CatalpaEel/mynpu/npu/docs/no-sram-cache.md

# 删除透明SRAM读缓存

当前XBAR不再包含SRAM缓存数据、tag、valid数组、命中判断、填充、失效或缓存返回数据寄存器；缓存容量参数也已删除。两块8KB SRAM、256B软件管理RF、流FIFO、4/4/4任务队列和VPG3指令。

## 兼容的诊断寄存器

| CSR | 当前语义 |
|---|---|
| `0x038` | 两个32位SRAM bank、总容量16384B，保持不变 |
| `0x03c` | `0x00020000`，两个bank，每bank零个缓存字 |
| `0x020 / 0x024` | 原命中计数位置，恒为零，不保留命中计数器 |
| `0x028 / 0x02c` | SRAM读请求计数，C头文件新增`NPU_SRAM_READS0/1`别名 |
| `0x030 / 0x034` | 每个SRAM bank接受的请求数，包含读写 |

保留原寄存器地址和旧C宏名以兼容诊断软件，没有保留缓存硬件或重新启用缓存的参数。VPG2 ABI不变。

## 当前验证入口

默认配置和性能使用[项目首页](../../README.md)；当前版本的功能、综合、最终PNR及检查证据统一见[报告索引](../reports/README.md)。
