CatalpaEel/mynpu/npu/fpga/ego1/MERGE-20261114.md

# EGo1板级分支与JTAG-only主线集成

2026-11-14。本地分支`integration/ego1-board-20261114-jtag-only`合并：

- 主线父提交：`a5ac998`，已删除GPIO及外部Host，保留SBA错误和子字访问。
- 板级父提交：`efc89fd`，远端`fpga/ego1-board-20261114-afb74fd`。

本次未推送远端，也未连接、烧写实体板。

## 合入内容

板级时钟可选10/25/50MHz、FPGA专用CPU LUTRAM映射、CNN DSP约束、面积策略、构建/装载/验证/打包脚本，以及旧10MHz实板的固定归档。构建入口默认25MHz，本次FPGA仿真和Vivado展开选择10MHz；ASIC验证保持50MHz。

自动合并没有文本冲突，但`tb_validation.sv`的ASIC实例仍带旧Host端口，已移除。当前生产`npu/rtl`及`external/`与`a5ac998`完全一致，因此没有恢复GPIO/Host、修改计算阵列或改动ASIC CPU寄存器堆。LUTRAM只在明确选择FPGA映射时替换编译清单。

`versions/ego1-10mhz-20261114`保留原始字节和哈希。其中旧源码的Host端口是历史证据，不参与当前默认编译；不能修改冻结文件后继续沿用旧bitstream/板测结论。

## 本次实际检查

| 检查 | 本次结果 |
| --- | --- |
| 旧板测归档完整性 | 257文件哈希通过，72个冻结编译源 |
| PC验证脚本测试 | 13项通过，包含数据损坏、超时、序号、RPC分片、错误传播和拒绝未完成构建打包 |
| FPGA CPU LUTRAM与原FF实现对照 | 20000随机周期，40000检查通过 |
| 当前FPGA：10MHz、LUTRAM CPU RF | 两次启动、20帧、8486检查通过 |
| 当前ASIC：50MHz、真实SRAM宏 | 两次启动、20帧、8486检查通过 |
| 当前Vivado 2025.2 RTL展开 | 通过，27844个展开实例，0错误、0严重警告 |

SoC仿真均经真实JTAG TAP/DTM/DM装载、读回16KiB镜像，检查双输入槽、READY/DONE序号、十个整数输出及复位/暂停恢复；不是Host后门驱动。它们包含显式halt/resume场景，不代替专门的不暂停CPU SBA压力测试，也不证明板上SBA故障已修复。

Vivado执行的是`synth_design -rtl`，没有执行完整工艺映射、布局布线或生成新镜像。261个普通警告保留：包参数按localparam处理100、未连接/无负载端口100、CPU寄存器set/reset优先级40、MMCM未用端口等。没有屏蔽警告或将其描述为全流程Clean。

[机器结果及源/证据哈希](../../reports/ego1_merge_validation_20261114.json)。本机输出在`npu/build/ego1-merge-{fpga,asic,cpu-rf,vivado}/`；旧板测报告和本次集成验证在报告索引中分别标记。

## 历史结论的边界

旧`afb74fd/03e2870`在Vivado 2023.2下的19799 LUT、10MHz setup +48.244ns/hold +0.019ns，以及2021次实板推理只适用于冻结归档。它使用主机访问前halt/之后resume的方案。当前JTAG-only代码更新了DM，不能直接下载旧镜像来验证这些新修改。

当前机器已安装Vivado 2025.2，使用`~/tools/bin/vivado`可避开本机运行库兼容问题。要制作当前版新镜像，可从仓库根目录使用新目录：

```bash
python3.12 npu/fpga/ego1/build.py --out npu/build/ego1-merged-new \
  --clock-mhz 10 --area-medium --cpu-rf-lutram --cnn-dsp \
  --vivado /home/s2400012841/tools/bin/vivado
```

这会启动完整构建，并要求默认资源DRC、setup/hold等通过后才输出bit/MCS。该命令不自动连接或烧写板卡。
