CatalpaEel/mynpu/npu/docs/images/logic-trim-fullchip.png

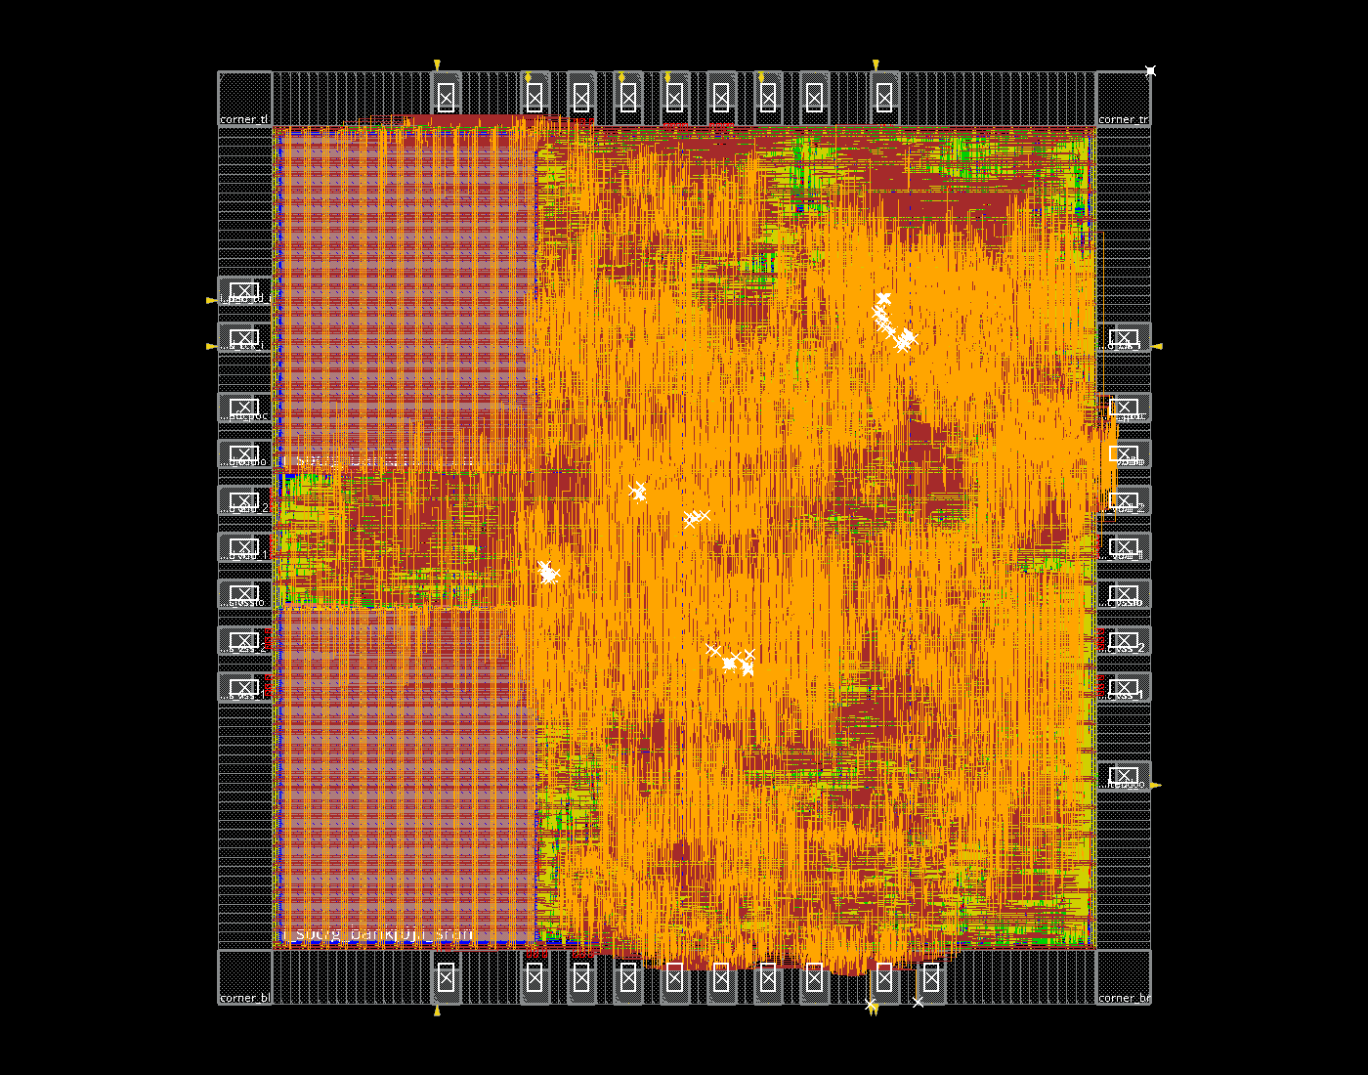
npu/docs/images/logic-trim-fullchip.png
