CatalpaEel/mynpu/npu/docs/images/regfile-pnr.png

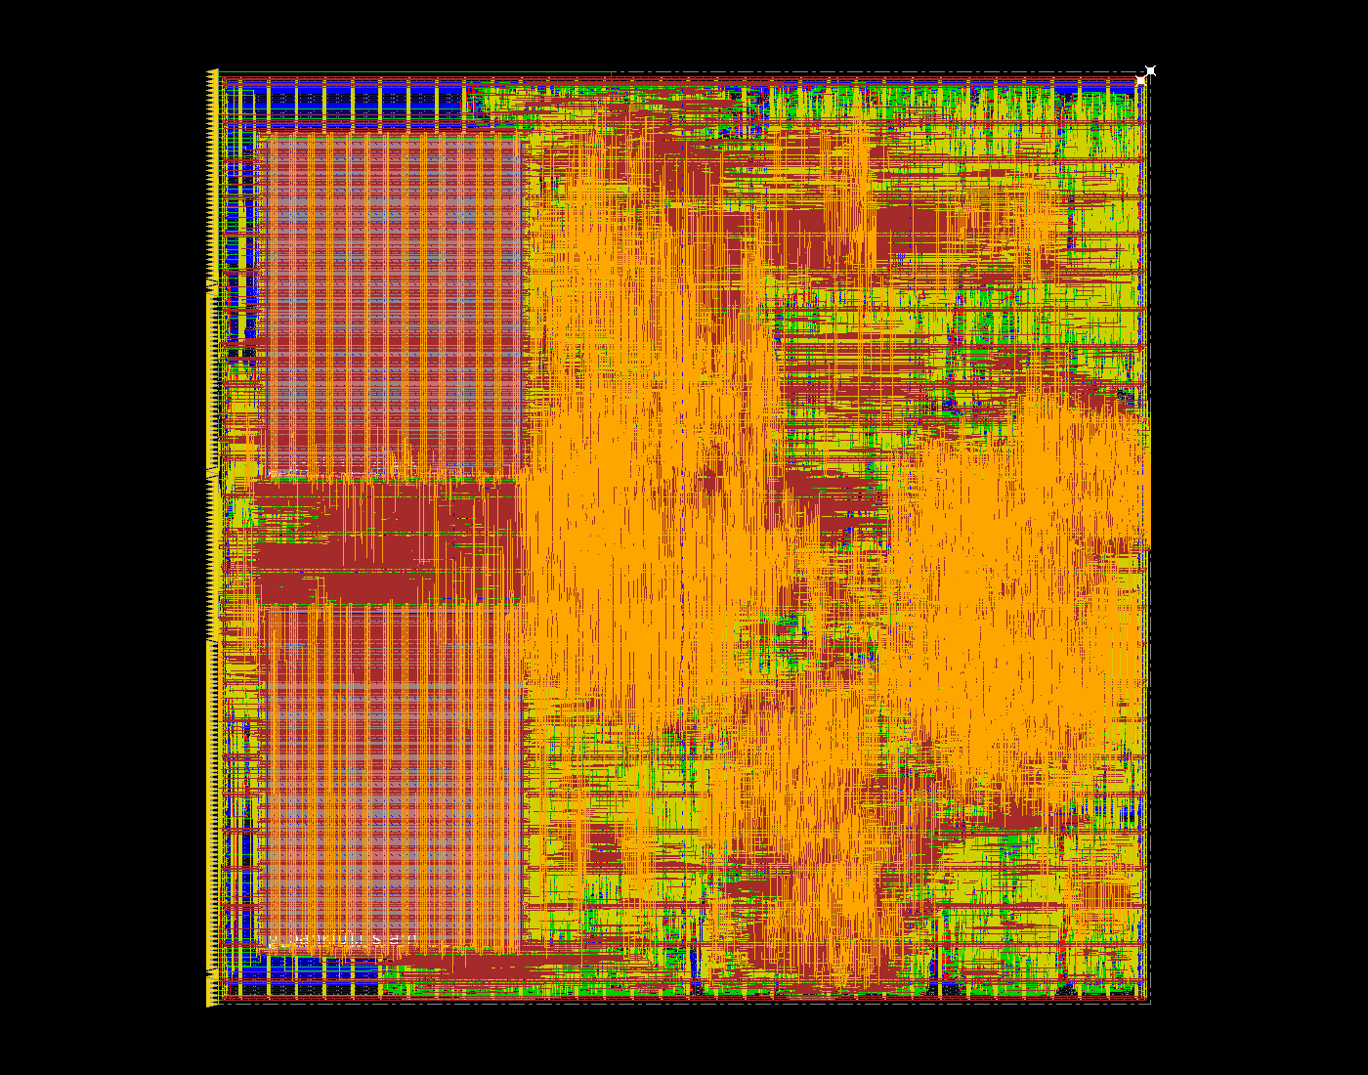
npu/docs/images/regfile-pnr.png
