CatalpaEel/mynpu/npu/docs/images/rf1r1w-r3-module-map-core.png

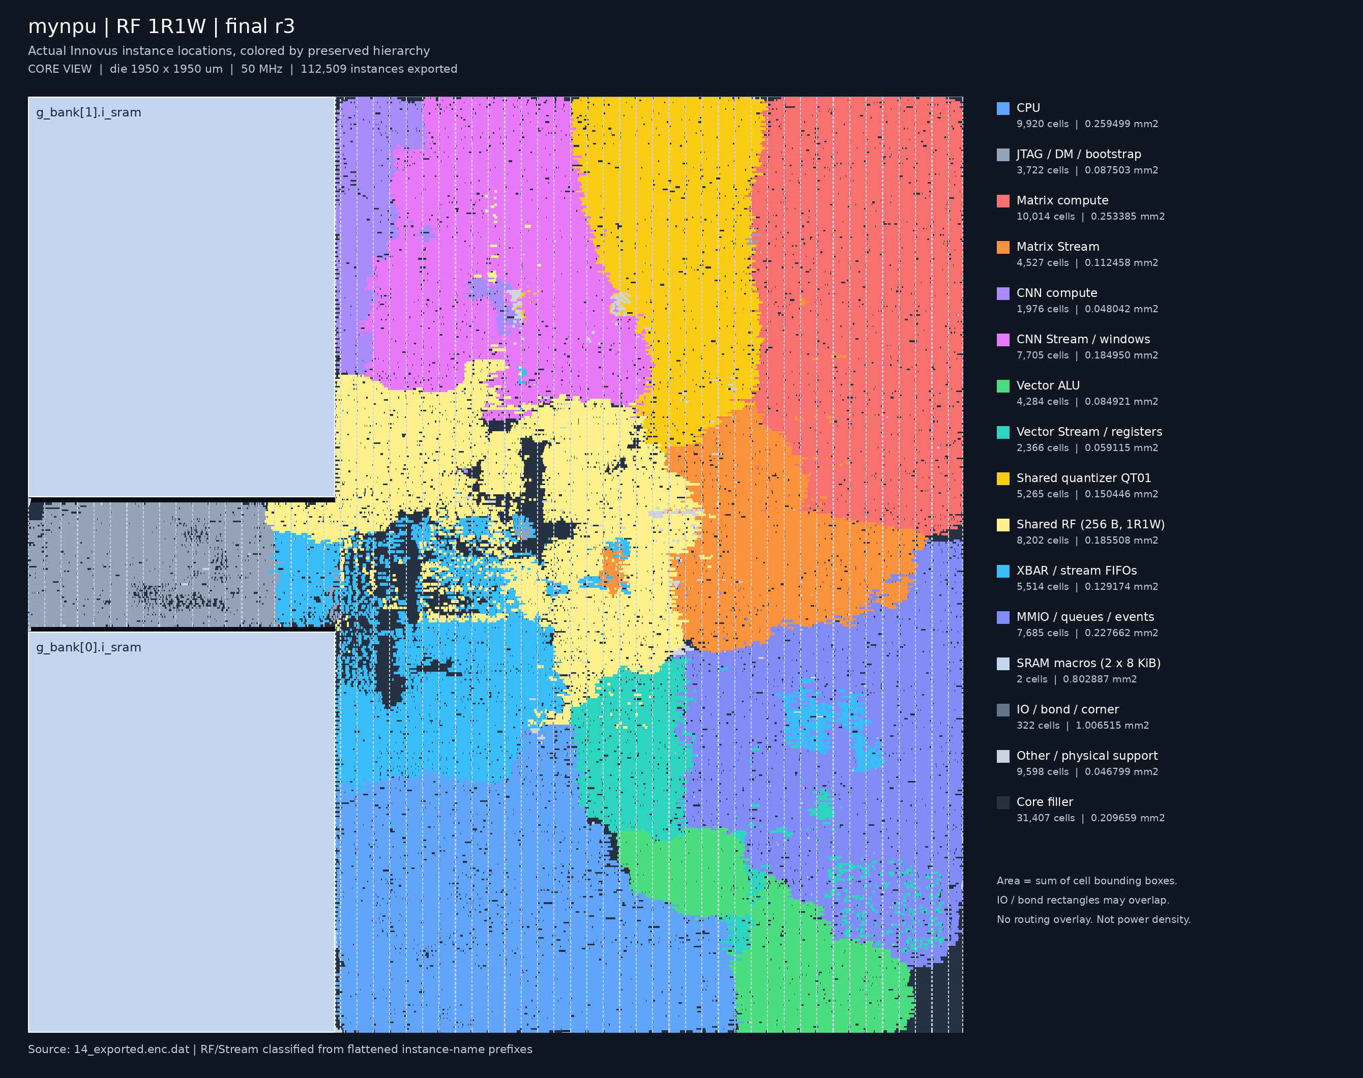
npu/docs/images/rf1r1w-r3-module-map-core.png
