CatalpaEel/mynpu/npu/docs/images/window-prefetch-module-gui.png

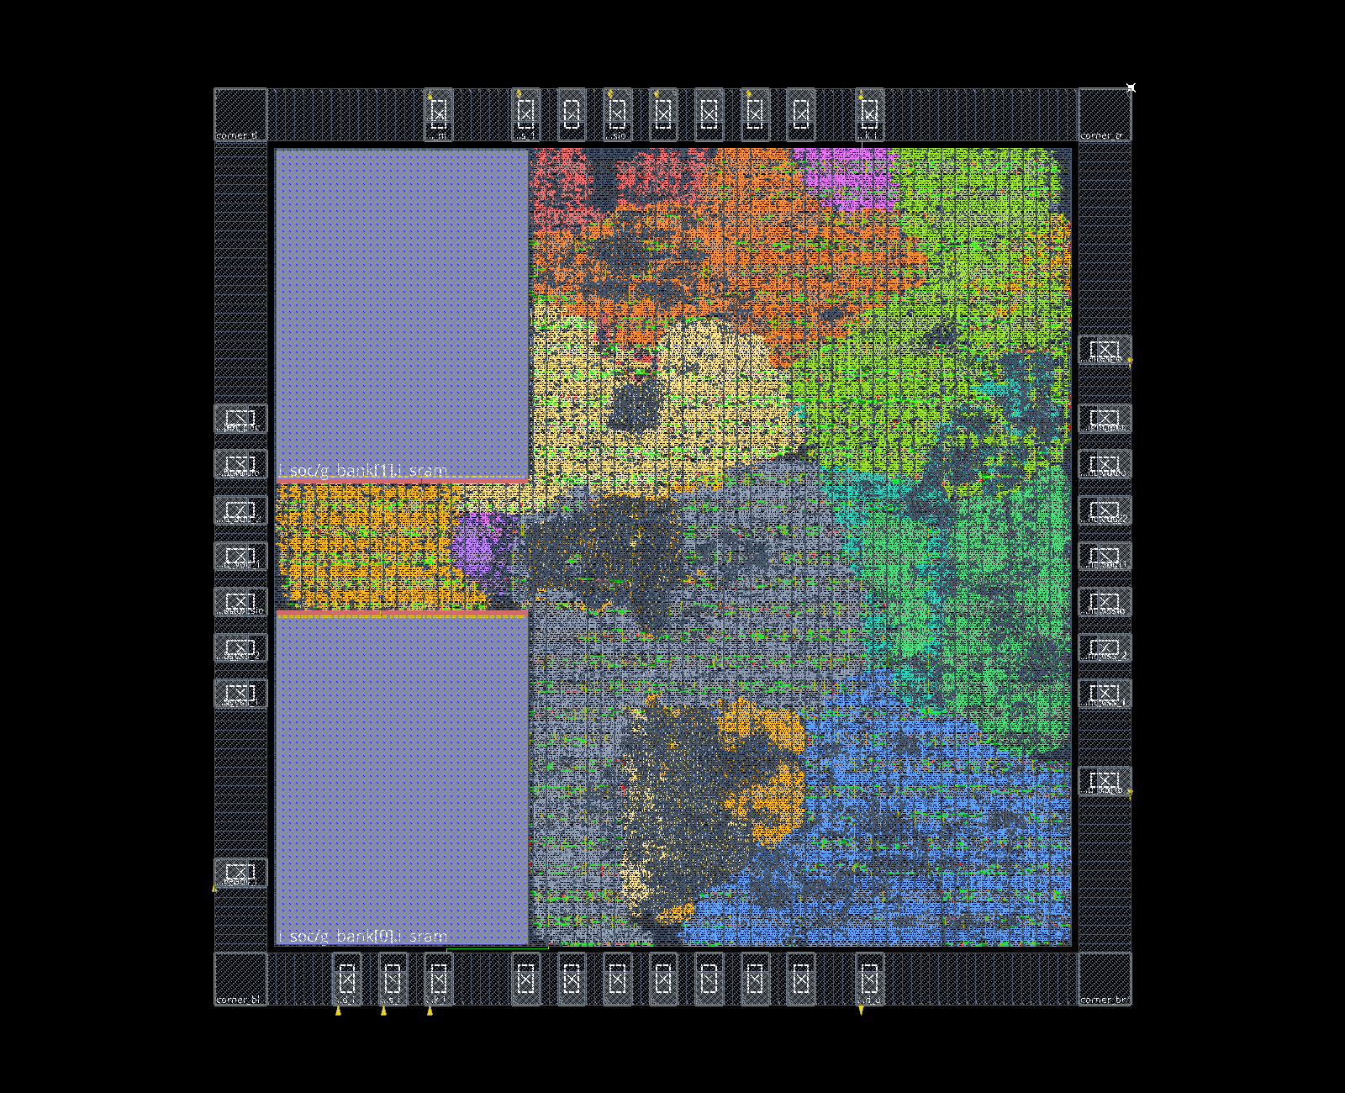
npu/docs/images/window-prefetch-module-gui.png
