CatalpaEel/mynpu/npu/docs/presentation/overview.png

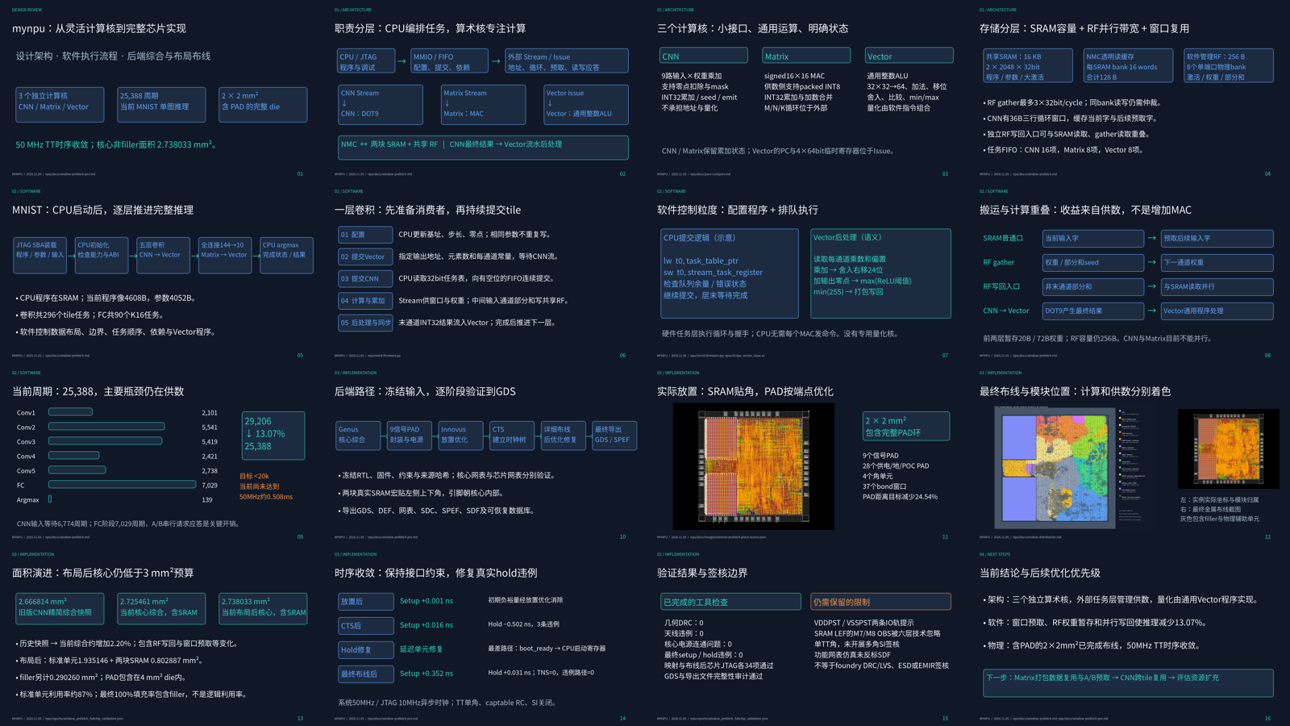
npu/docs/presentation/overview.png
