CatalpaEel/mynpu/npu/docs/presentation/slide-01.png

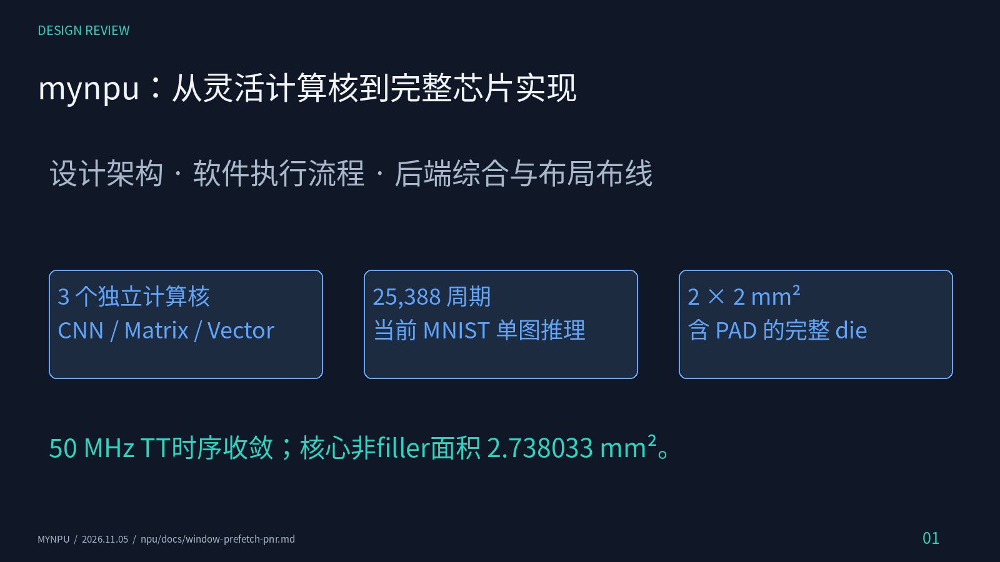
npu/docs/presentation/slide-01.png
