CatalpaEel/mynpu/npu/docs/presentation/slide-02.png

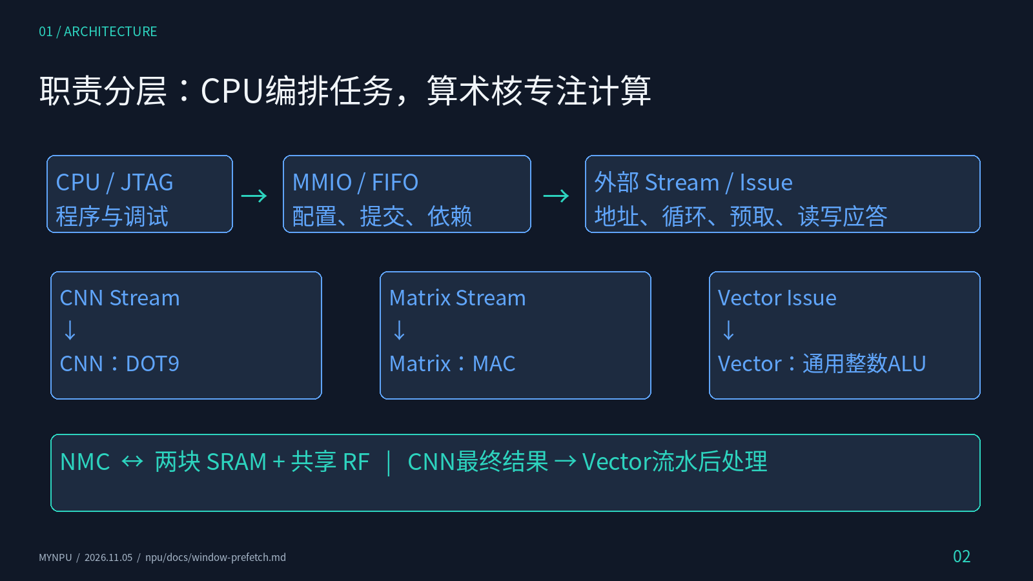
npu/docs/presentation/slide-02.png
