CatalpaEel/mynpu/npu/docs/presentation/slide-03.png

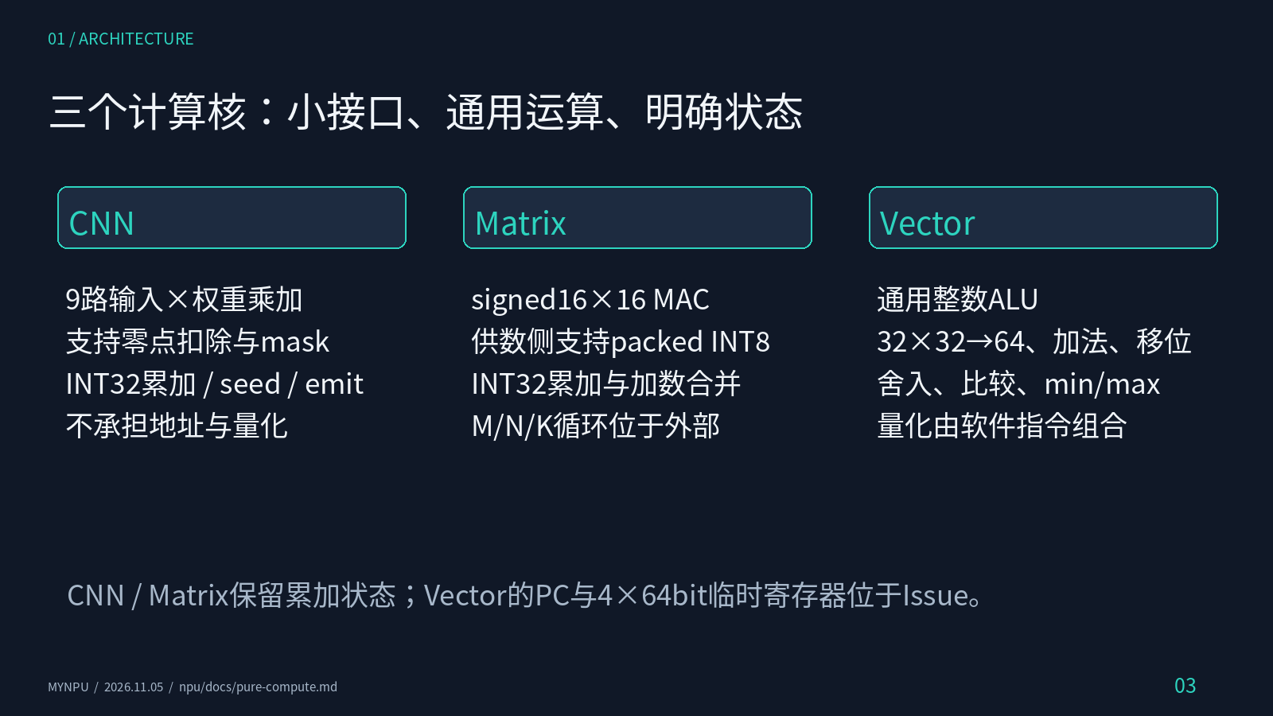
npu/docs/presentation/slide-03.png
