CatalpaEel/mynpu/npu/docs/presentation/slide-04.png

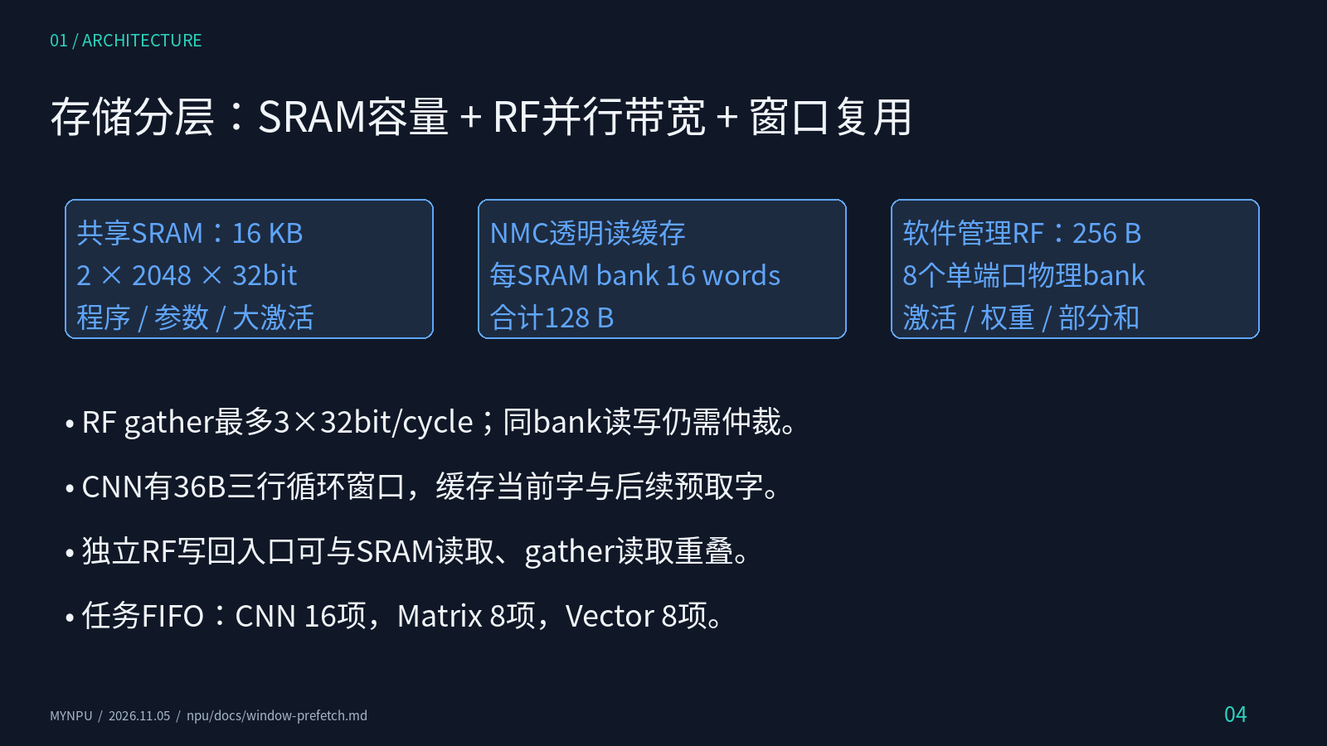
npu/docs/presentation/slide-04.png
