CatalpaEel/mynpu/npu/docs/presentation/slide-05.png

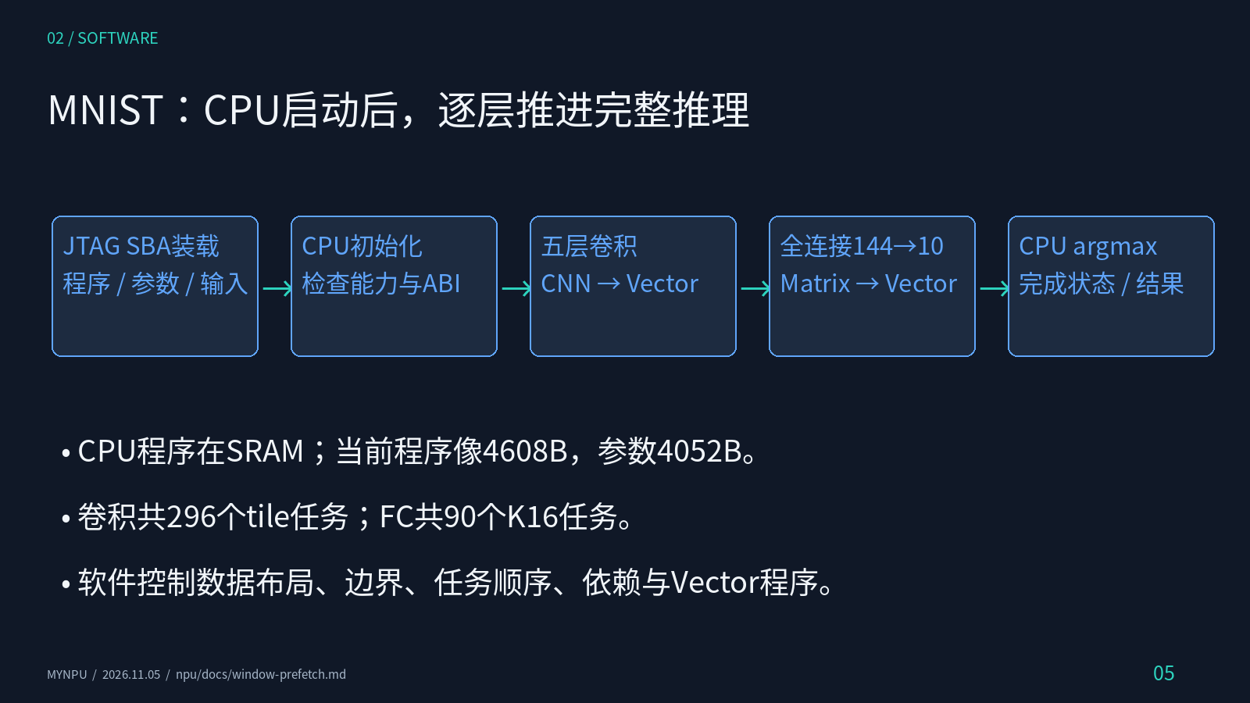
npu/docs/presentation/slide-05.png
