CatalpaEel/mynpu/npu/docs/presentation/slide-06.png

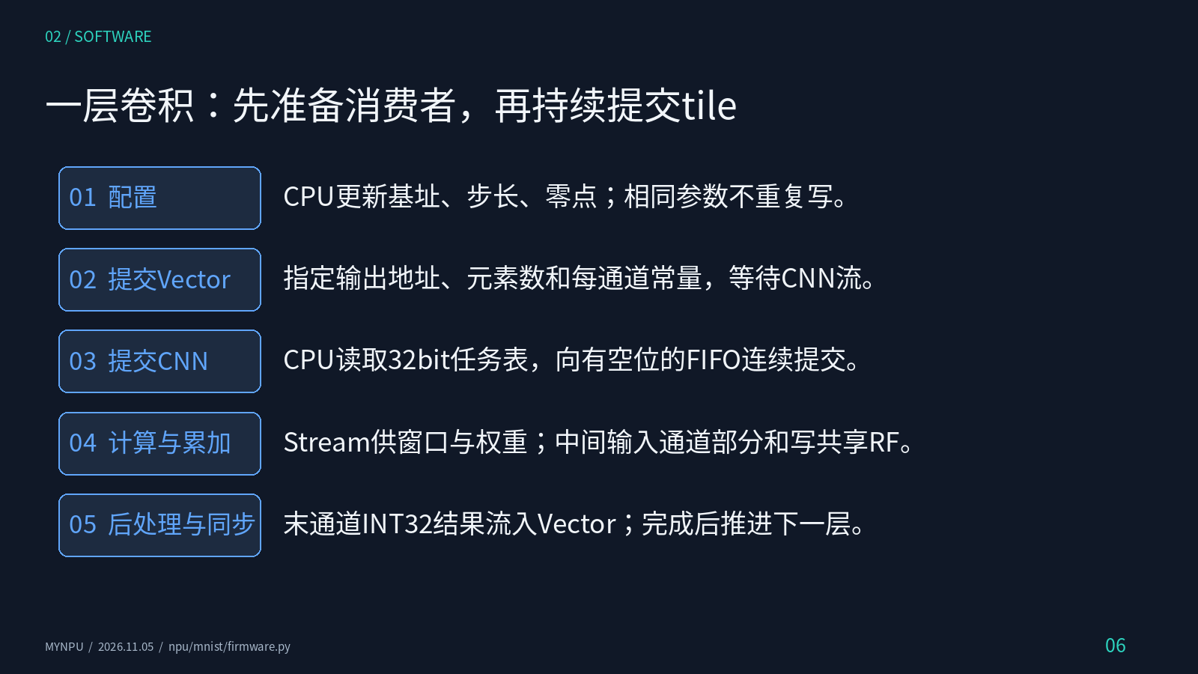
npu/docs/presentation/slide-06.png
