CatalpaEel/mynpu/npu/docs/presentation/slide-07.png

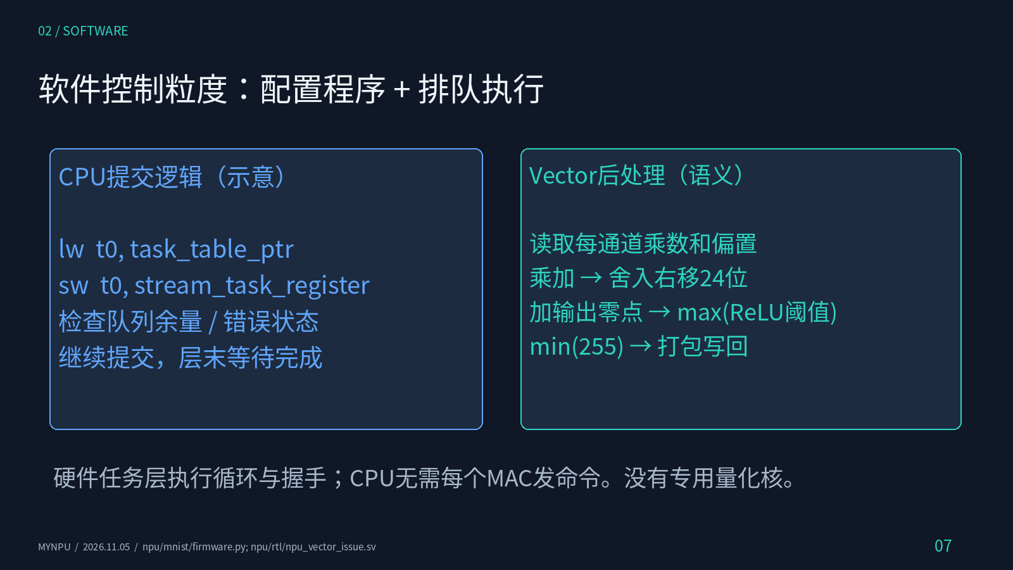
npu/docs/presentation/slide-07.png
