CatalpaEel/mynpu/npu/docs/presentation/slide-08.png

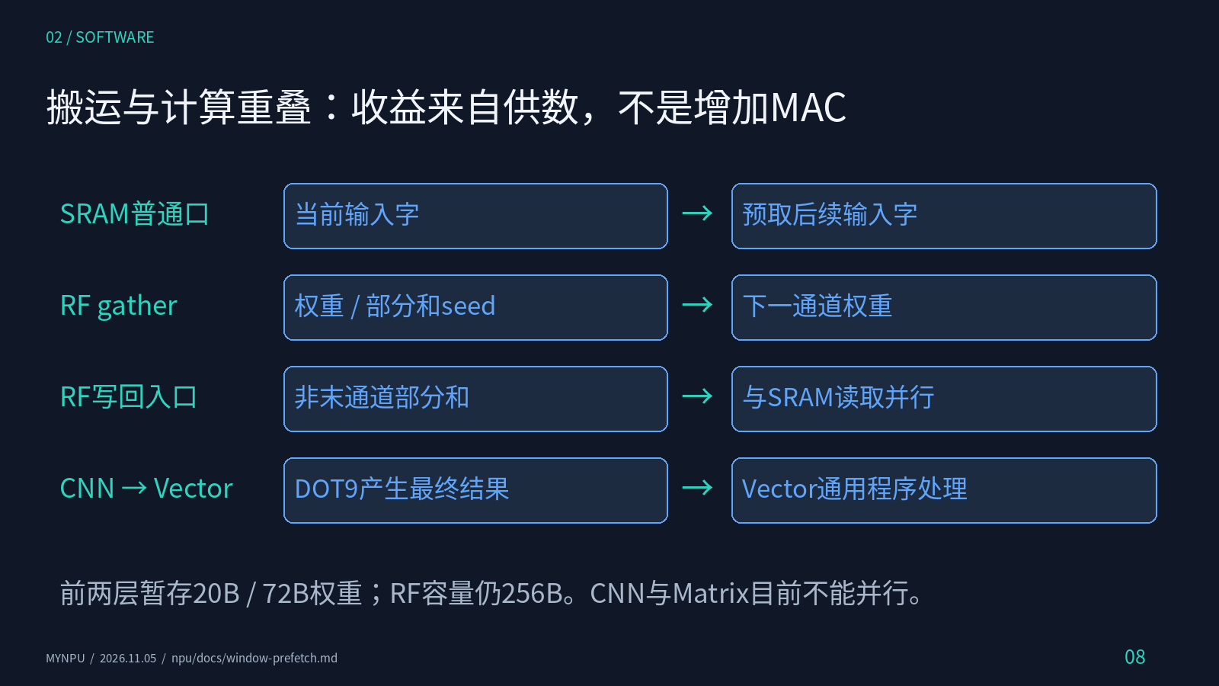
npu/docs/presentation/slide-08.png
