CatalpaEel/mynpu/npu/docs/presentation/slide-09.png

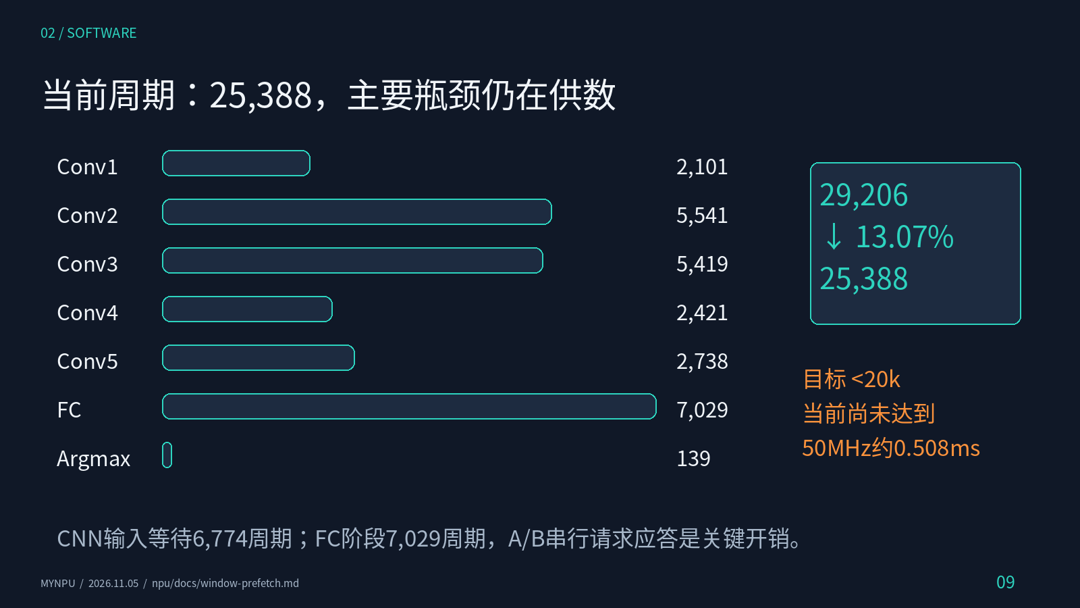
npu/docs/presentation/slide-09.png
