CatalpaEel/mynpu/npu/docs/presentation/slide-10.png

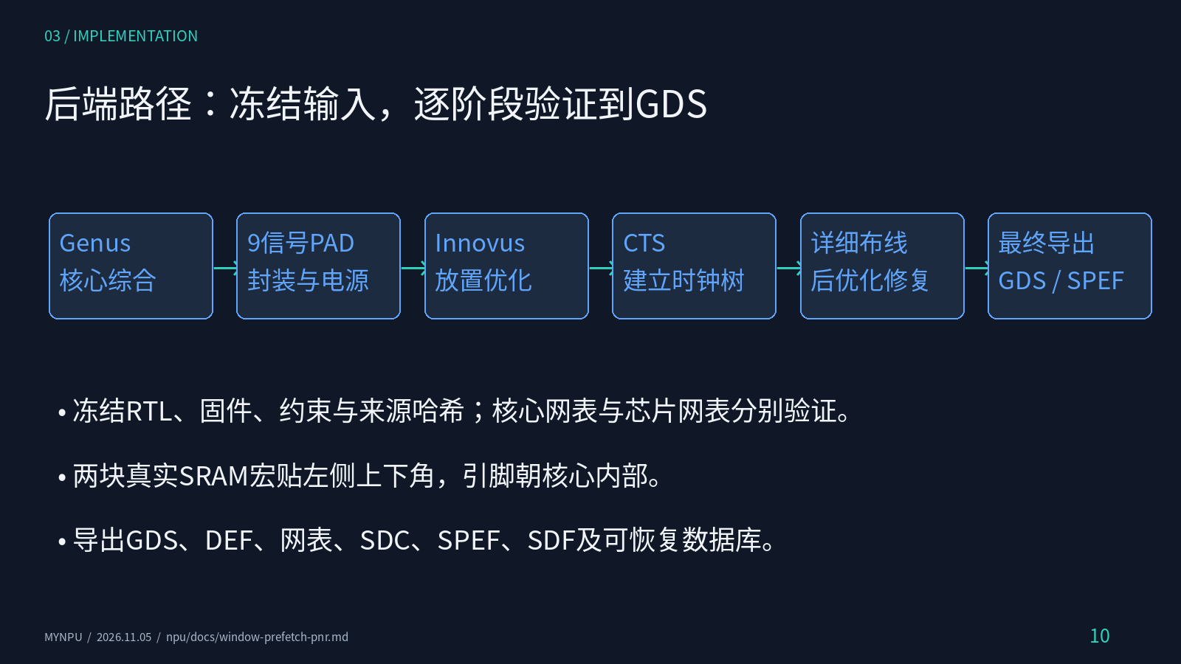
npu/docs/presentation/slide-10.png
