CatalpaEel/mynpu/npu/docs/presentation/slide-11.png

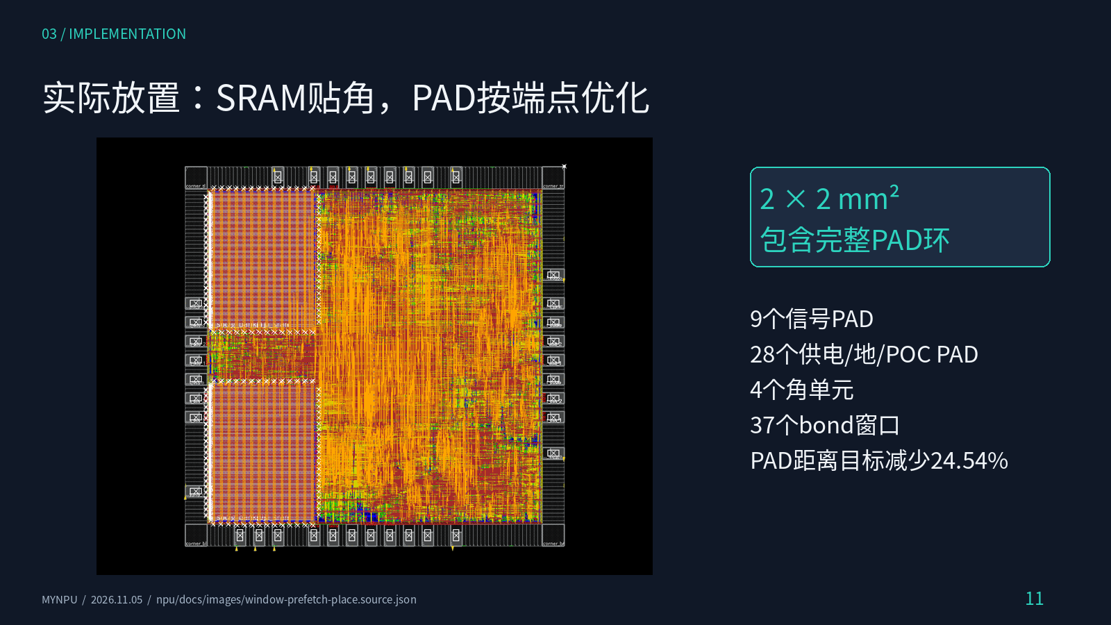
npu/docs/presentation/slide-11.png
