CatalpaEel/mynpu/npu/docs/presentation/slide-12.png

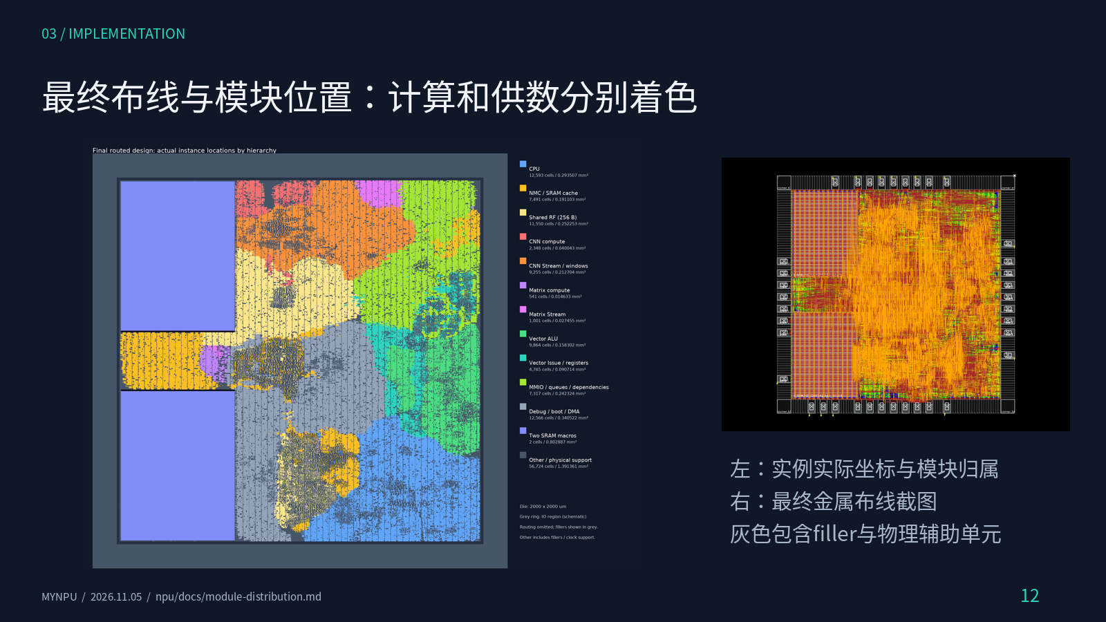
npu/docs/presentation/slide-12.png
