CatalpaEel/mynpu/npu/docs/presentation/slide-13.png

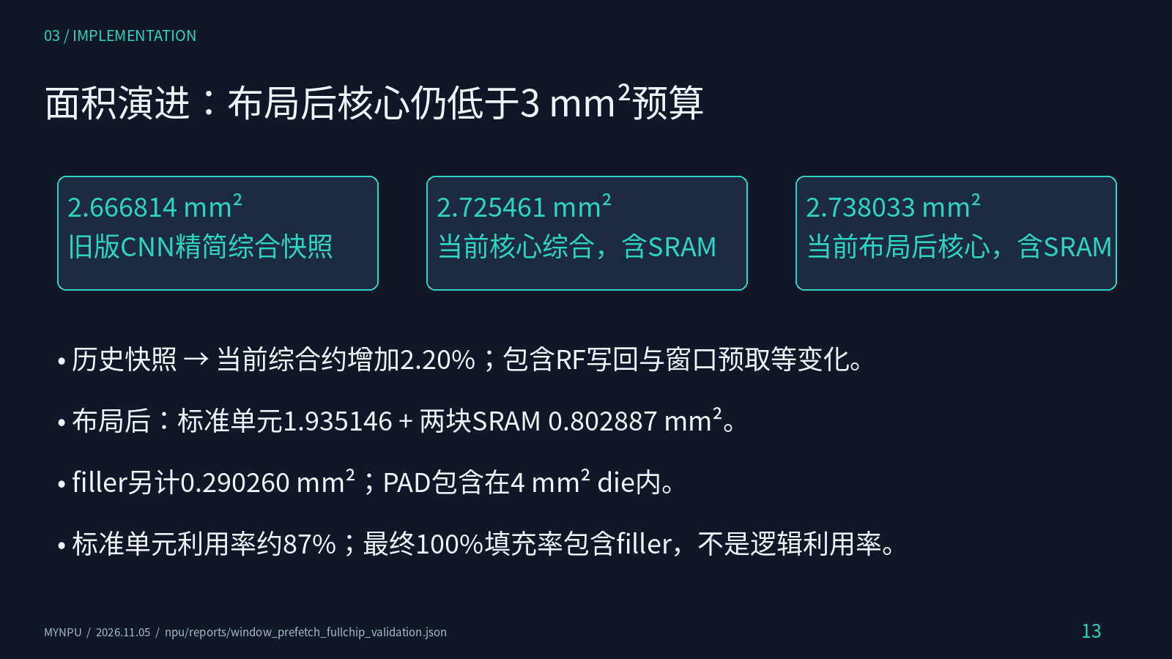
npu/docs/presentation/slide-13.png
