CatalpaEel/mynpu/npu/docs/presentation/slide-14.png

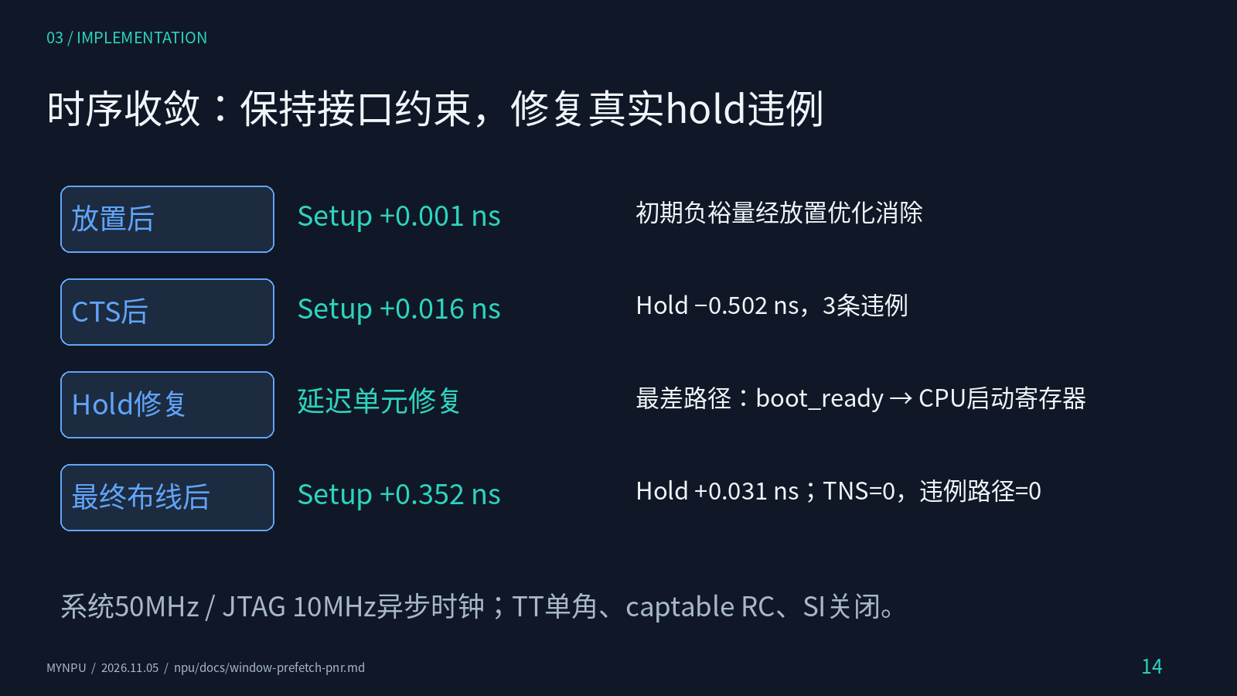
npu/docs/presentation/slide-14.png
