CatalpaEel/mynpu/npu/docs/presentation/slide-15.png

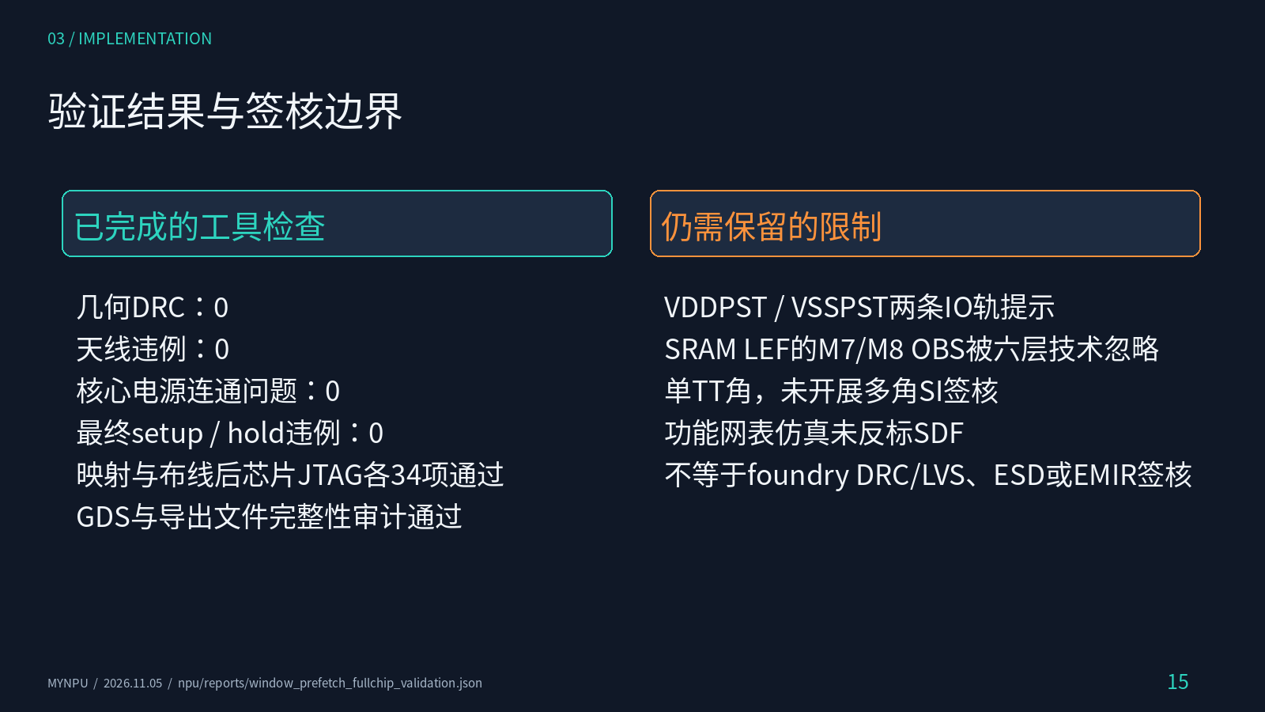
npu/docs/presentation/slide-15.png
