CatalpaEel/mynpu/npu/docs/presentation/slide-16.png

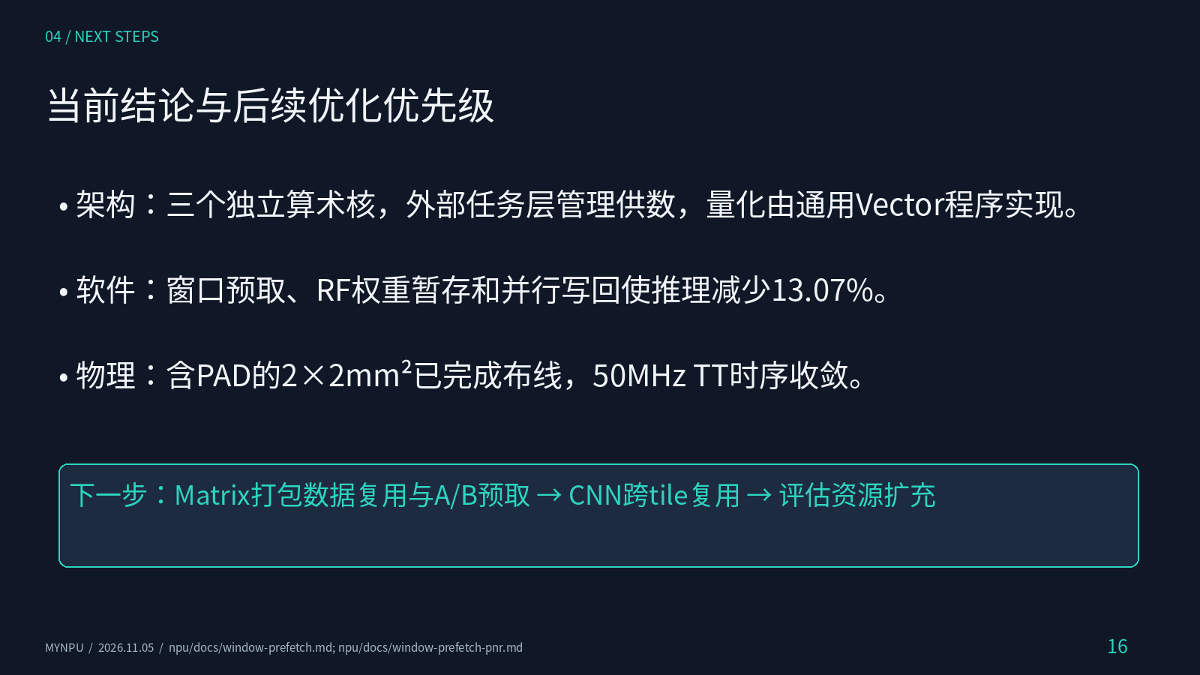
npu/docs/presentation/slide-16.png
