CatalpaEel/mynpu/npu/sw/npu.h

#ifndef NPU_H
#define NPU_H
#include <stdint.h>
/* Local machine interrupt IDs. Boot wake remains IRQ31. */
#define NPU_IRQ_MATRIX 16u
#define NPU_IRQ_VECTOR 17u
#define NPU_IRQ_CNN 18u
#define NPU_IRQ_MASK 0x00070000u
#define NPU_IRQ_CAP 0x070u
#define NPU_CONTROL_START 1u
#define NPU_CONTROL_CLEAR_IDLE 2u
#define NPU_CONTROL_ACK_DONE 8u
#define NPU_SRAM_BASE 0x80000000u
#define NPU_SRAM_BYTES 16384u
#define NPU_BANK_BYTES 8192u
#define NPU_BANK0_BASE NPU_SRAM_BASE
#define NPU_BANK1_BASE (NPU_SRAM_BASE + NPU_BANK_BYTES)
/* Uncached SRAM: legacy hits read zero; former misses count SRAM read requests. */
#define NPU_SRAM_READS0 0x028u
#define NPU_SRAM_READS1 0x02cu
#define NPU_CACHE_HITS0 0x020u
#define NPU_CACHE_HITS1 0x024u
#define NPU_CACHE_MISSES0 0x028u
#define NPU_CACHE_MISSES1 0x02cu
#define NPU_STREAM_CHANNEL_CAP 0x060u
#define NPU_STREAM_CHANNEL_BASE 0x064u
#define NPU_STREAM_ENDPOINT(channel) (0x80006000u + ((uint32_t)(channel) << 8))
#define NPU_MEMORY_CAP 0x038u
#define NPU_CACHE_CAP 0x03cu
#define NPU_REGFILE_CAP 0x050u
#define NPU_REGFILE_BASE_REG 0x054u
#define NPU_REGFILE_BASE 0x80004000u
static inline uint32_t npu_regfile_bank_bytes(void);
/* Additive LY01 layout / EV01 sticky task events. All masks are 8 bits.
 * Events are not consumed by WAIT: software clears them before safe reuse.
 * Successful completion signals after write acknowledgement; faults do not.
 */
#define NPU_LAYOUT_CAP 0x094u
#define NPU_LAYOUT_ABI 0x4c593031u
#define NPU_EVENT_CAP 0x088u
#define NPU_EVENT_ABI 0x45563031u
#define NPU_EVENT_SET 0x08cu
#define NPU_EVENT_CLEAR 0x090u
#define NPU_MAT_LDC 0x158u
#define NPU_MAT_EVENTS 0x15cu
#define NPU_VEC_A_STRIDE 0x28cu
#define NPU_VEC_B_STRIDE 0x290u
#define NPU_VEC_D_STRIDE 0x294u
#define NPU_VEC_LAYOUT 0x298u
#define NPU_VEC_EVENTS 0x29cu
#define NPU_CNN_EVENTS 0x674u
#define NPU_VEC_FINAL_ONLY 1u
#define NPU_VEC_KEEP_R2 2u
#define NPU_VEC_STRIDES 4u
struct npu_vector_layout {
  int32_t a_stride, b_stride, d_stride;
  uint32_t flags, events;
};
static inline uint32_t npu_task_events(unsigned wait_mask, unsigned signal_mask) {
  return (wait_mask & 255u) | ((signal_mask & 255u) << 8);
}
static inline int npu_vector_layout_valid(const struct npu_vector_layout *l, int packed) {
  return l && l->flags <= 7u && l->events <= 65535u && l->a_stride >= -32768 &&
         l->a_stride <= 32767 && l->b_stride >= -32768 && l->b_stride <= 32767 &&
         l->d_stride >= -32768 && l->d_stride <= 32767 &&
         (!(l->flags & NPU_VEC_STRIDES) ||
          (!(l->a_stride & 3) && !(l->b_stride & 3) && (packed || !(l->d_stride & 3))));
}
#define NPU_MAT_CONTROL 0x100u
#define NPU_MAT_STATUS 0x104u
#define NPU_VEC_CONTROL 0x200u
#define NPU_VEC_STATUS 0x204u
#define NPU_MAT_QUEUE 0x124u
#define NPU_MAT_COMPLETED 0x128u
#define NPU_MAT_SUBMITTED 0x12cu
#define NPU_VEC_QUEUE 0x224u
#define NPU_VEC_COMPLETED 0x228u
#define NPU_VEC_SUBMITTED 0x22cu
/* Operator ABI 2.2, project-defined integer kernels (not an ISA extension). */
#define NPU_OPERATOR_ABI 0x040u
/* Read-only observation ABI 2; bits0..6 include packed-write cancellations. */
#define NPU_SYNC_CAP 0x084u
#define NPU_SYNC_ABI_V1 0x0001003fu
#define NPU_SYNC_ABI_V2 0x0002007fu
#define NPU_MAT_STARTED 0x144u
#define NPU_MAT_STARTED_TICKET 0x148u
#define NPU_MAT_FAULTS 0x14cu
#define NPU_MAT_OBSERVE 0x150u
#define NPU_MAT_SYNC_STATE 0x154u
#define NPU_VEC_STARTED 0x238u
#define NPU_VEC_STARTED_TICKET 0x23cu
#define NPU_VEC_FAULTS 0x280u
#define NPU_VEC_OBSERVE 0x284u
#define NPU_VEC_SYNC_STATE 0x288u
#define NPU_CNN_STARTED 0x634u
#define NPU_CNN_STARTED_TICKET 0x638u
#define NPU_CNN_FAULTS 0x63cu
#define NPU_CNN_CANCELLED 0x648u
#define NPU_CNN_OBSERVE 0x64cu
#define NPU_CNN_SYNC_STATE 0x650u
#define NPU_SYNC_BUSY (1u << 0)
#define NPU_SYNC_LAUNCH (1u << 1)
#define NPU_SYNC_QUEUED (1u << 2)
#define NPU_SYNC_DONE_PULSE (1u << 3)
#define NPU_SYNC_FAULT_PULSE (1u << 4)
#define NPU_SYNC_BLOCKED (1u << 5)
/* Relative to NPU_QUANT_SYNC_BASE(source). Counts wrap, reset only on reset. */
#define NPU_QUANT_SYNC_BASE(source) (0x700u + ((uint32_t)(source) << 6))
#define NPU_QUANT_ACCEPTED 0x24u
#define NPU_QUANT_ISSUED 0x28u
#define NPU_QUANT_WRITTEN 0x2cu
#define NPU_QUANT_WRITE_ERRORS 0x30u
#define NPU_QUANT_FLUSHED 0x34u
#define NPU_QUANT_SYNC_STATE 0x38u
#define NPU_QUANT_WRITE_CANCELLED 0x3cu
/* Valid for less than 2^31 events between baseline and observation. Following
 * a fault/cancellation, started/completed event counts are not submit tickets. */
static inline int npu_counter_reached(uint32_t observed, uint32_t target) {
  return observed - target < 0x80000000u;
}
#define NPU_RUNTIME_CONFIG_CAP 0x080u /* bits0..3: CNN, Matrix, Vector, quant */
#define NPU_GEMM_CAP 0x044u
#define NPU_VECTOR_CAP 0x048u
#define NPU_CNN_CAP 0x04cu
#define NPU_MAT_FLAGS 0x130u
#define NPU_VEC_SCALAR 0x230u
#define NPU_GEMM_TRANS_A 1u
#define NPU_GEMM_TRANS_B 2u
#define NPU_GEMM_ACCUMULATE 4u
#define NPU_MATRIX_PRECISION 0x13cu
#define NPU_MATRIX_ELEMENT_BYTES 0x140u
#define NPU_PRECISION_INT8 0u
#define NPU_PRECISION_INT16 1u
#define NPU_VECTOR_SCALAR 128u
enum npu_vector_op {
  NPU_V_RELU = 0,
  NPU_V_ADD = 1,
  NPU_V_COPY = 2,
  NPU_V_SUB = 3,
  NPU_V_MIN = 4,
  NPU_V_MAX = 5,
  NPU_V_AND = 6,
  NPU_V_OR = 7,
  NPU_V_XOR = 8,
  NPU_V_SHL = 9,
  NPU_V_SHR = 10,
  NPU_V_SAR = 11,
  NPU_V_EQ = 12,
  NPU_V_NEG = 13,
  NPU_V_ABS = 14,
  NPU_V_NOT = 15,
  NPU_V_MUL32 = 24,
  NPU_V_RSHR32 = 26,
  NPU_V_LD32 = 27,
  NPU_V_ADDC = 16,
  NPU_V_ADC = 17,
  NPU_V_SLTU = 18,
  NPU_V_MULHU = 19,
  NPU_V_MULH = 20,
  NPU_V_SHRD = 21,
  NPU_V_RSHRD = 22,
  NPU_V_ADCSX = 23,
  NPU_V_SCALAR = 29
};
enum npu_cnn_op { NPU_CONV = 0 };
#define NPU_V_PROGRAM 32u
#define NPU_V_SIMD8 64u
#define NPU_V_SCALAR_INPUT 128u
#define NPU_VECTOR_SIMD_CAP 0x068u
#define NPU_V_PACK_U8 256u
#define NPU_VECTOR_PROGRAM_ABI 0x058u
#define NPU_VECTOR_PROGRAM_ABI_V3 0x56504733u
#define NPU_VEC_PROGRAM_CFG 0x234u
#define NPU_VEC_PROGRAM_WORDS 0x240u
struct npu_gemm_descriptor {
  uint32_t a, b, d, m, n, k, flags, precision, element_bytes, lda, ldb;
};
struct npu_vector_descriptor {
  uint32_t a, b, d, len, op, scalar;
};
#define NPU_MMIO_BASE 0x40000000u
#define NPU_BUSY 1u
#define NPU_DONE 2u
#define NPU_ERROR 4u
/* Optional transport hooks also allow host-side validation of queue helpers. */
#ifndef NPU_MMIO_READ32
#define NPU_MMIO_READ32(address) (*(volatile uint32_t *)(uintptr_t)(address))
#endif
#ifndef NPU_MMIO_WRITE32
#define NPU_MMIO_WRITE32(address, value) (*(volatile uint32_t *)(uintptr_t)(address) = (value))
#endif
#ifndef NPU_IO_FENCE
#define NPU_IO_FENCE() __asm__ volatile("fence iorw, iorw" ::: "memory")
#endif
static inline void npu_write(uint32_t offset, uint32_t value) {
  NPU_MMIO_WRITE32(NPU_MMIO_BASE + offset, value);
}
static inline uint32_t npu_read(uint32_t offset) { return NPU_MMIO_READ32(NPU_MMIO_BASE + offset); }

/* GPIO8 on the XBAR MMIO slave: full aligned 32-bit accesses, low byte only.
 * DIR bit 1 drives OUT; bit 0 releases the corresponding bidirectional pin.
 * Write OUT before enabling DIR to avoid an unintended transition. No IRQ.
 */
#define NPU_GPIO_IN 0x800u
#define NPU_GPIO_OUT 0x804u
#define NPU_GPIO_DIR 0x808u
#define NPU_GPIO_SET 0x80cu
#define NPU_GPIO_CLEAR 0x810u
#define NPU_GPIO_TOGGLE 0x814u
#define NPU_GPIO_CAP 0x818u
static inline uint8_t npu_gpio_read(void) { return (uint8_t)npu_read(NPU_GPIO_IN); }
static inline void npu_gpio_write(uint8_t value) { npu_write(NPU_GPIO_OUT, value); }
static inline void npu_gpio_direction(uint8_t outputs) { npu_write(NPU_GPIO_DIR, outputs); }
static inline void npu_gpio_set(uint8_t mask) { npu_write(NPU_GPIO_SET, mask); }
static inline void npu_gpio_clear(uint8_t mask) { npu_write(NPU_GPIO_CLEAR, mask); }
static inline void npu_gpio_toggle(uint8_t mask) { npu_write(NPU_GPIO_TOGGLE, mask); }
/* Read only NPU-local pending sources; CPU mie controls wake/interrupt masks. */
static inline uint32_t npu_irq_pending(void) {
  uint32_t value;
  __asm__ volatile("csrr %0, mip" : "=r"(value));
  return value & NPU_IRQ_MASK;
}
/* Acknowledge done while active; error and completion counters are unchanged. */
static inline void npu_irq_ack_done(uint32_t control_offset) {
  npu_write(control_offset, NPU_CONTROL_ACK_DONE);
}
static inline void npu_fence(void) { NPU_IO_FENCE(); }
static inline uint32_t npu_regfile_bank_bytes(void) {
  return (npu_read(NPU_REGFILE_CAP) & 65535u) * 4u;
}
/* Returns 0 on completion, -1 on command error, -2 on timeout. */
static inline int npu_wait(uint32_t status_offset, uint32_t timeout) {
  while (timeout--) {
    uint32_t s = npu_read(status_offset);
    if (s & NPU_ERROR)
      return -1;
    if ((s & (NPU_BUSY | NPU_DONE)) == NPU_DONE) {
      npu_fence();
      return 0;
    }
  }
  return -2;
}
/* Nonblocking descriptor enqueue; software must serialize shadow-CSR producers.
 * Queue depth excludes the active job. A snapshot is captured on CONTROL.start.
 * Buffer dependencies across queued jobs/units remain a software responsibility. */
static inline int npu_queue_has_space(uint32_t offset) {
  uint32_t q = npu_read(offset);
  return (q & 0xffffu) < (q >> 16);
}
/* Completion tickets are modulo 2^32; keep fewer than 2^31 outstanding. */
static inline int npu_queue_wait(uint32_t completed, uint32_t status, uint32_t ticket,
                                 uint32_t timeout) {
  while (timeout--) {
    if (npu_read(status) & NPU_ERROR)
      return -1;
    if ((int32_t)(npu_read(completed) - ticket) >= 0) {
      npu_fence();
      return 0;
    }
  }
  return -2;
}
static inline int npu_matmul_start(uint32_t a, uint32_t b, uint32_t d, uint32_t m, uint32_t n,
                                   uint32_t k) {
  if (!npu_queue_has_space(NPU_MAT_QUEUE))
    return -1;
  uint32_t before = npu_read(NPU_MAT_SUBMITTED);
  npu_write(0x108, a);
  npu_write(0x10c, b);
  npu_write(0x110, d);
  npu_write(0x114, m);
  npu_write(0x118, n);
  npu_write(0x11c, k);
  npu_write(NPU_MATRIX_PRECISION, NPU_PRECISION_INT8);
  npu_write(NPU_MATRIX_ELEMENT_BYTES, 4);
  npu_write(0x134, 0);
  npu_write(0x138, 0);
  npu_write(NPU_MAT_FLAGS, 0);
  npu_write(NPU_MAT_LDC, 0);
  npu_write(NPU_MAT_EVENTS, 0);
  npu_fence();
  npu_write(0x100, 1);
  return npu_read(NPU_MAT_SUBMITTED) == before + 1u ? 0 : -1;
}
static inline int npu_vector_start(uint32_t a, uint32_t b, uint32_t d, uint32_t len, uint32_t op) {
  if (op > 15u)
    return -1; /* Scalar form uses npu_elementwise_start. */
  if (!npu_queue_has_space(NPU_VEC_QUEUE))
    return -1;
  uint32_t before = npu_read(NPU_VEC_SUBMITTED);
  npu_write(0x208, a);
  npu_write(0x218, b);
  npu_write(0x20c, d);
  npu_write(0x210, len);
  npu_write(0x214, op);
  npu_write(NPU_VEC_LAYOUT, 0);
  npu_write(NPU_VEC_EVENTS, 0);
  npu_fence();
  npu_write(0x200, 1);
  return npu_read(NPU_VEC_SUBMITTED) == before + 1u ? 0 : -1;
}
/* Dense row-major GEMM, D=op(A)*op(B), or D+= when ACCUMULATE.
 * All bases are 4-byte aligned; packed rows need no padding. INT32 output.
 * Precision selects signed INT8/INT16. element_bytes independently selects
 * a 1/2/4-byte storage slot; INT16 needs at least 2. Accumulation wraps INT32. */
/* Per-job limits; address capacity can impose a tighter bound. */
#define NPU_MATRIX_SHAPE_CAP 0x074u /* [31:16]=K, [15:8]=N, [7:0]=M */
#define NPU_VECTOR_LENGTH_CAP 0x078u
#define NPU_CNN_INPUT_CHANNEL_CAP 0x07cu
#define NPU_MATRIX_MAX_M 16u
#define NPU_MATRIX_MAX_N 16u
#define NPU_MATRIX_MAX_K 256u
#define NPU_VECTOR_MAX_ELEMENTS 4096u
#define NPU_CNN_MAX_INPUT_CHANNELS 256u
#define NPU_MATRIX_OUTER_CAP 0x06cu
#define NPU_MATRIX_LDA 0x134u
#define NPU_MATRIX_LDB 0x138u
/* Configure stride shadows for raw-MMIO submissions; START snapshots them.
 * npu_gemm_start uses its descriptor lda/ldb. Zero selects dense layout. */
static inline int npu_gemm_leading_dims(uint32_t lda, uint32_t ldb) {
  if (lda > 4096u || ldb > 4096u || npu_read(NPU_MATRIX_OUTER_CAP) != 0x00040404u)
    return -1;
  npu_write(NPU_MATRIX_LDA, lda);
  npu_write(NPU_MATRIX_LDB, ldb);
  return 0;
}
static inline int npu_gemm_start_layout(const struct npu_gemm_descriptor *d, uint32_t ldc,
                                        uint32_t events) {
  if (!d || ldc > 4096u || (ldc && ldc < d->n) || events > 65535u)
    return -1;
  if ((npu_read(NPU_OPERATOR_ABI) >> 16) != 2u || (d->flags & ~npu_read(NPU_GEMM_CAP)))
    return -1;
  if (d->precision > 1 ||
      (d->element_bytes != 1 && d->element_bytes != 2 && d->element_bytes != 4) ||
      (d->precision && d->element_bytes < 2) || d->lda > 4096 || d->ldb > 4096)
    return -1;
  if (!npu_queue_has_space(NPU_MAT_QUEUE))
    return -1;
  uint32_t before = npu_read(NPU_MAT_SUBMITTED);
  npu_write(0x108, d->a);
  npu_write(0x10c, d->b);
  npu_write(0x110, d->d);
  npu_write(0x114, d->m);
  npu_write(0x118, d->n);
  npu_write(0x11c, d->k);
  npu_write(NPU_MATRIX_PRECISION, d->precision);
  npu_write(NPU_MATRIX_ELEMENT_BYTES, d->element_bytes);
  npu_write(NPU_MATRIX_LDA, d->lda);
  npu_write(NPU_MATRIX_LDB, d->ldb);
  npu_write(NPU_MAT_FLAGS, d->flags);
  npu_write(NPU_MAT_LDC, ldc);
  npu_write(NPU_MAT_EVENTS, events);
  npu_fence();
  npu_write(0x100, 1);
  return npu_read(NPU_MAT_SUBMITTED) == before + 1u ? 0 : -1;
}
static inline int npu_gemm_start(const struct npu_gemm_descriptor *d) {
  return npu_gemm_start_layout(d, 0, 0);
}
/* Optional direct CNN/Matrix result quantizer. Software owns update timing.
 * Arithmetic parameters are sampled per result; enable/pack/dst are live.
 * A zero control preserves raw INT32.
 * Destination describes the final output; Matrix D still names raw partials.
 */
#define NPU_QUANT_CNN 0u
#define NPU_QUANT_MATRIX 1u
#define NPU_QUANT_CAP 0x780u
#define NPU_QUANT_ABI 0x51543031u
struct npu_quant_config {
  uint32_t control, multiplier, bias, shift, zero, lower, upper, input_offset, dst;
};
static inline int npu_quant_configure(uint32_t source, const struct npu_quant_config *q) {
  if (source > 1u || !q || npu_read(NPU_QUANT_CAP) != NPU_QUANT_ABI || q->control > 3u ||
      q->control == 2u || q->shift > 32u || (int32_t)q->lower > (int32_t)q->upper ||
      (q->control == 1u && (q->dst & 3u)) ||
      (q->control == 3u && q->dst >= 0x80006000u && q->dst < 0x80006400u))
    return -1;
  uint32_t base = 0x700u + source * 64u;
  if (q->control && !((q->dst - NPU_SRAM_BASE < NPU_SRAM_BYTES) ||
                      (q->dst - NPU_REGFILE_BASE < 2u * npu_regfile_bank_bytes()) ||
                      (q->control == 1u && q->dst >= 0x80006000u && q->dst < 0x80006400u)))
    return -1;
  npu_write(base, 0);
  if (!q->control)
    return 0;
  npu_write(base + 4, q->multiplier);
  npu_write(base + 8, q->bias);
  npu_write(base + 12, q->shift);
  npu_write(base + 16, q->zero);
  npu_write(base + 20, q->lower);
  npu_write(base + 24, q->upper);
  npu_write(base + 28, q->input_offset);
  npu_write(base + 32, q->dst);
  npu_fence();
  npu_write(base, q->control);
  return 0;
}
/* Extended traversal bounds, aliases and KEEP_R2 lifetime are software-owned.
 * SIMD strides advance once per four-byte group. Packed program D strides
 * advance per output byte. With STRIDES clear, legacy dense addressing applies.
 */
static inline int npu_elementwise_start_layout(const struct npu_vector_descriptor *d,
                                               const struct npu_vector_layout *l) {
  if (!d || !npu_vector_layout_valid(l, d->op == 0x120u))
    return -1;
  uint32_t opcode = d->op & 31u;
  int program = (d->op == 0x20u || d->op == 0x120u || d->op == 0x60u);
  if ((npu_read(NPU_OPERATOR_ABI) >> 16) != 2u ||
      (program ? npu_read(NPU_VECTOR_PROGRAM_ABI) != NPU_VECTOR_PROGRAM_ABI_V3
               : ((d->op & ~0xdfu) != 0 || !(npu_read(NPU_VECTOR_CAP) & (1u << opcode)))))
    return -1;
  if (!npu_queue_has_space(NPU_VEC_QUEUE))
    return -1;
  uint32_t before = npu_read(NPU_VEC_SUBMITTED);
  npu_write(0x208, d->a);
  npu_write(0x218, d->b);
  npu_write(0x20c, d->d);
  npu_write(0x210, d->len);
  npu_write(0x214, d->op);
  npu_write(NPU_VEC_SCALAR, d->scalar);
  npu_write(NPU_VEC_A_STRIDE, (uint32_t)l->a_stride);
  npu_write(NPU_VEC_B_STRIDE, (uint32_t)l->b_stride);
  npu_write(NPU_VEC_D_STRIDE, (uint32_t)l->d_stride);
  npu_write(NPU_VEC_LAYOUT, l->flags);
  npu_write(NPU_VEC_EVENTS, l->events);
  npu_fence();
  npu_write(0x200, 1);
  return npu_read(NPU_VEC_SUBMITTED) == before + 1u ? 0 : -1;
}
static inline int npu_elementwise_start(const struct npu_vector_descriptor *d) {
  const struct npu_vector_layout dense = {4, 4, 4, 0, 0};
  return npu_elementwise_start_layout(d, &dense);
}
#define NPU_CPU_CONTROL 0x008u
#define NPU_CPU_BOOT_ADDR 0x00cu
/* Program words can be written while running. Software owns consistency.
 * Count/loop are latched per job; instruction words are read live. Each job has
 * four 32-bit temporaries: r0=input/result, initial r1=B, r2=0, r3=scalar.
 * Slots [0,loop) run once, [loop,count) repeat for each input element.
 * Packed U8 output stores the low byte; software must explicitly clamp.
 */
static inline uint32_t npu_vector_insn(unsigned op, unsigned rd, unsigned ra, unsigned rb,
                                       int immediate, int use_immediate) {
  return (op & 31u) | ((rd & 3u) << 6) | ((ra & 3u) << 8) | ((rb & 3u) << 10) |
         ((use_immediate != 0) << 5) | (((uint32_t)immediate & 0xfffffu) << 12);
}
/* SHRD/RSHRD take low/high registers and a 0..32 immediate shift. */
static inline uint32_t npu_vector_shift_pair(unsigned op, unsigned rd, unsigned low, unsigned high,
                                             unsigned shift) {
  return shift <= 32u ? npu_vector_insn(op, rd, low, high, 0, 0) | (shift << 12) : 31u;
}
static inline int npu_vector_program_configure(const uint32_t *words, unsigned count,
                                               unsigned loop) {
  if (count == 0 || count > 16 || loop >= count ||
      npu_read(NPU_VECTOR_PROGRAM_ABI) != NPU_VECTOR_PROGRAM_ABI_V3)
    return -1;
  for (unsigned i = 0; i < count; i++)
    npu_write(NPU_VEC_PROGRAM_WORDS + 4 * i, words[i]);
  npu_write(NPU_VEC_PROGRAM_CFG, count | (loop << 8));
  npu_fence();
  return 0;
}
/* SD95: shared input/kernel/geometry may be changed while running.
 * The engine latches them at dispatch, not when the window is queued. */
#define NPU_STREAM_ABI 0x654u
#define NPU_STREAM_ABI_V5 0x53443935u
#define NPU_CNN_KERNEL 0x60cu
#define NPU_CNN_WINDOW 0x628u
#define NPU_CNN_QUEUE 0x658u
#define NPU_CNN_COMPLETED 0x65cu
#define NPU_CNN_SUBMITTED 0x660u
#define NPU_CNN_TOTAL_CYCLES 0x664u
#define NPU_CNN_TOTAL_MACS 0x668u
#define NPU_CNN_MAC_LANES 0x66cu
#define NPU_STREAM_TASK_CAP 0x670u
#define NPU_CNN_MAX_POSITIONS 16u
#define NPU_CNN_PARTIAL_BYTES (NPU_CNN_MAX_POSITIONS * 4u)
struct npu_stream_config {
  uint32_t src, kernel, dst, row_stride, partial, cin, stride, plane_stride, input_zero, mode;
};
static inline int npu_data_span(uint32_t a, uint32_t n, uint32_t rf_bytes) {
  uint64_t end = (uint64_t)a + n;
  return n && ((a >= 0x80006000u && a < 0x80006400u) ||
               (a >= NPU_SRAM_BASE && end <= NPU_REGFILE_BASE) ||
               (a >= NPU_REGFILE_BASE && end <= (uint64_t)NPU_REGFILE_BASE + rf_bytes));
}
static inline int npu_spans_overlap(uint32_t a, uint32_t n, uint32_t b, uint32_t m) {
  return (uint64_t)a < (uint64_t)b + m && (uint64_t)b < (uint64_t)a + n;
}
static inline int npu_stream_configure(const struct npu_stream_config *d) {
  uint32_t rf_bytes = npu_regfile_bank_bytes() * 2;
  if (npu_read(NPU_STREAM_ABI) != NPU_STREAM_ABI_V5)
    return -1;
  if ((d->src & 3u) || !npu_data_span(d->src, 1, rf_bytes) ||
      !npu_data_span(d->kernel, 1, rf_bytes) ||
      (!d->mode && ((d->dst & 3u) || !npu_data_span(d->dst, 4, rf_bytes))) ||
      d->partial < NPU_REGFILE_BASE || (d->partial & 3u) ||
      !npu_data_span(d->partial, 4, rf_bytes) || !d->row_stride || d->row_stride > 32767 ||
      !d->plane_stride || d->plane_stride > 32767 || !d->cin || d->cin > 256 ||
      (d->stride != 1 && d->stride != 2) || d->input_zero > 255 || d->mode != 0)
    return -1;
  npu_write(0x608, d->src);
  npu_write(NPU_CNN_KERNEL, d->kernel);
  npu_write(0x610, d->dst);
  npu_write(0x614, d->row_stride);
  npu_write(0x618, d->partial);
  npu_write(0x61c, d->cin);
  npu_write(0x620, d->stride);
  npu_write(0x624, d->plane_stride);
  npu_write(0x62c, d->input_zero);
  npu_write(0x630, d->mode);
  npu_fence();
  return 0;
}
static inline uint32_t npu_stream_task(unsigned y, unsigned x, unsigned count, unsigned rows,
                                       int left, int right, unsigned dst_words) {
  /* Unchecked packer: callers supply count 1..16; use the checked form for validation. */
  return ((count - 1u) & 15u) | ((rows & 7u) << 4) | ((left != 0) << 7) | ((right != 0) << 8) |
         ((x & 127u) << 9) | ((y & 127u) << 16) | ((dst_words & 511u) << 23);
}
static inline int npu_stream_task_checked(unsigned y, unsigned x, unsigned count, unsigned rows,
                                          int left, int right, unsigned dst_words, uint32_t *task) {
  if (!task || !count || count > NPU_CNN_MAX_POSITIONS || y > 127 || x > 127 || rows > 7 ||
      dst_words > 511)
    return -1;
  *task = npu_stream_task(y, x, count, rows, left, right, dst_words);
  return 0;
}
static inline int npu_stream_submit_events(uint32_t task, uint32_t events) {
  if (events > 65535u)
    return -1;
  if (npu_read(NPU_STREAM_ABI) != NPU_STREAM_ABI_V5 ||
      !npu_data_span(npu_read(0x618), ((task & 15u) + 1u) * 4u, npu_regfile_bank_bytes() * 2u) ||
      !npu_data_span(npu_read(NPU_CNN_KERNEL), npu_read(0x61c) * 9u,
                     npu_regfile_bank_bytes() * 2u) ||
      !npu_queue_has_space(NPU_CNN_QUEUE) || (npu_read(0x604) & NPU_ERROR))
    return -1;
  uint32_t before = npu_read(NPU_CNN_SUBMITTED);
  npu_write(NPU_CNN_WINDOW, task);
  npu_write(NPU_CNN_EVENTS, events);
  npu_fence();
  npu_write(0x600, 1);
  return npu_read(NPU_CNN_SUBMITTED) == before + 1u ? 0 : -1;
}
static inline int npu_stream_submit(uint32_t task) { return npu_stream_submit_events(task, 0); }
/* Source-level compatibility adapter. The old binary CRW2 ABI is retired.
 * Full convolution shape, tensor ranges and partial-buffer aliasing are now
 * software checks; raw MMIO callers must enforce equivalent ownership rules. */
struct npu_cnn_descriptor {
  uint32_t src, weights, dst, width, height, cin, stride, output_width, output_row, input_zero, op;
};
static inline int npu_cnn_descriptor_valid(const struct npu_cnn_descriptor *d, uint32_t rf_bytes) {
  if (rf_bytes < 4 || d->op != 0 || !d->width || d->width > 128 || !d->height || d->height > 128 ||
      !d->cin || d->cin > 256 || (d->stride != 1 && d->stride != 2) || d->input_zero > 255 ||
      (d->src & 3u))
    return 0;
  if (!d->output_width || d->output_width > (d->width + d->stride - 1) / d->stride ||
      d->output_row >= (d->height + d->stride - 1) / d->stride)
    return 0;
  uint32_t inputs = d->width * d->height * d->cin, weights = d->cin * 9u,
           output = d->output_width * 4u;
  uint32_t partial_bytes = (d->output_width > 16 ? 16 : d->output_width) * 4u;
  if (rf_bytes < partial_bytes)
    return 0;
  uint32_t partial = NPU_REGFILE_BASE + rf_bytes - partial_bytes;
  if (!npu_data_span(d->src, inputs, rf_bytes) || !npu_data_span(d->weights, weights, rf_bytes) ||
      npu_spans_overlap(partial, partial_bytes, d->src, inputs) ||
      npu_spans_overlap(partial, partial_bytes, d->weights, weights))
    return 0;
  return (!(d->dst & 3u) && npu_data_span(d->dst, output, rf_bytes) &&
          !npu_spans_overlap(d->dst, output, d->src, inputs) &&
          !npu_spans_overlap(d->dst, output, d->weights, weights) &&
          !npu_spans_overlap(d->dst, output, partial, partial_bytes));
}
/* Validate the whole row, then enqueue windows as space becomes available.
 * Returns after all windows are accepted, not after compute completes.
 * queue_timeout counts queue-full polls across this row. On timeout/fault,
 * already accepted windows may still execute; no transactional rollback.
 */
static inline int npu_cnn_start_wait(const struct npu_cnn_descriptor *d, uint32_t queue_timeout) {
  if (!d)
    return -1;
  uint32_t bytes = npu_regfile_bank_bytes() * 2;
  if (!npu_cnn_descriptor_valid(d, bytes))
    return -1;
  struct npu_stream_config cfg = {d->src,
                                  d->weights,
                                  d->dst,
                                  d->width,
                                  NPU_REGFILE_BASE + bytes -
                                      (d->output_width > 16 ? 16 : d->output_width) * 4u,
                                  d->cin,
                                  d->stride,
                                  d->width * d->height,
                                  d->input_zero,
                                  d->op};
  if (npu_stream_configure(&cfg))
    return -1;
  unsigned mask = 0;
  for (int r = 0; r < 3; r++) {
    int y = (int)(d->output_row * d->stride) + r - 1;
    if (y >= 0 && y < (int)d->height)
      mask |= 1u << r;
  }
  for (unsigned x = 0; x < d->output_width; x += 16) {
    unsigned n = d->output_width - x > 16 ? 16 : d->output_width - x;
    uint32_t task;
    while (!npu_queue_has_space(NPU_CNN_QUEUE)) {
      if (npu_read(0x604) & NPU_ERROR)
        return -1;
      if (!queue_timeout)
        return -2;
      queue_timeout--;
    }
    if (npu_stream_task_checked(d->output_row, x, n, mask, x == 0,
                                (x + n - 1) * d->stride + 1 >= d->width, x, &task) ||
        npu_stream_submit(task))
      return -1;
  }
  return 0;
}
/* Legacy nonblocking row enqueue. A row must fit the physical queue capacity.
 * Use start_wait or cnn_layer to stream wider rows through a smaller queue.
 */
static inline int npu_cnn_start(const struct npu_cnn_descriptor *d) {
  if (!d || (npu_read(NPU_CNN_QUEUE) >> 16) < (d->output_width + 15) / 16)
    return -1;
  int result = npu_cnn_start_wait(d, 0);
  return result == -2 ? -1 : result;
}
/* Blocking reference adapter. Optimized assembly batches commands per layer. */
static inline int npu_cnn_layer(struct npu_cnn_descriptor row, uint32_t channels, uint32_t rows,
                                uint32_t timeout) {
  uint32_t rf_bytes = npu_regfile_bank_bytes() * 2;
  if (!channels || !rows || !npu_cnn_descriptor_valid(&row, rf_bytes) ||
      channels > NPU_SRAM_BYTES / (row.cin * 9u) ||
      rows > (row.height + row.stride - 1) / row.stride)
    return -1;
  uint32_t inputs = row.width * row.height * row.cin;
  uint32_t weights = channels * row.cin * 9;
  uint32_t output = channels * rows * row.output_width * 4;
  uint32_t partial_bytes = (row.output_width > 16 ? 16 : row.output_width) * 4u;
  uint32_t partial = NPU_REGFILE_BASE + rf_bytes - partial_bytes;
  /* Validate the entire layer before an early row can overwrite later inputs. */
  if (!npu_data_span(row.weights, weights, rf_bytes) ||
      npu_spans_overlap(partial, partial_bytes, row.weights, weights) ||
      (!row.op && (!npu_data_span(row.dst, output, rf_bytes) ||
                   npu_spans_overlap(row.dst, output, row.src, inputs) ||
                   npu_spans_overlap(row.dst, output, row.weights, weights) ||
                   npu_spans_overlap(row.dst, output, partial, partial_bytes))))
    return -1;
  for (uint32_t c = 0; c < channels; c++) {
    for (uint32_t y = 0; y < rows; y++) {
      row.output_row = y;
      int rc = npu_cnn_start_wait(&row, timeout);
      if (rc)
        return rc;
      uint32_t ticket = npu_read(NPU_CNN_SUBMITTED), remaining = timeout;
      while ((int32_t)(npu_read(NPU_CNN_COMPLETED) - ticket) < 0) {
        if (npu_read(0x604) & NPU_ERROR)
          return -1;
        if (!remaining--)
          return -2;
      }
      row.dst += row.output_width * 4;
    }
    row.weights += row.cin * 9;
  }
  return 0;
}
/* RF compute gather: lanes[23:16], physical banks[15:8], bits/lane[7:0]. */
#define NPU_RF_GATHER_CAP 0x05cu
#endif
