CatalpaEel/mynpu/npu/fpga/ego1/versions/ego1-10mhz-20261114/hardware/src/npu/rtl/matrix/npu_matrix_stream.sv

// Tiled GEMM feeder for the pure 4x4 outer-product core.
// Eight operand words retain the current A-column/B-row fragments across K.
// Matching packed lanes share a word fetch; up to three distinct words use RF
// gather together, and SRAM/FIFO reads use the original single ordinary port.
// Strides are in elements: zero selects the original dense layout.
module npu_matrix_stream #(
  parameter bit GATHER = 0
) (
  output logic [2:0] gather_req_o,
  output logic [2:0][31:0] gather_addr_o,
  input logic [2:0] gather_gnt_i,
  gather_valid_i,
  gather_error_i,
  input logic [2:0][31:0] gather_data_i,
  output logic compute_valid_o,
  compute_flush_o,
  compute_multiply_o,
  compute_emit_o,
  output logic [3:0] compute_row_mask_o,
  compute_col_mask_o,
  compute_index_o,
  output logic signed [3:0][15:0] compute_a_o,
  compute_b_o,
  output logic [31:0] compute_addend_o,
  input logic compute_ready_i,
  compute_result_valid_i,
  output logic compute_result_ready_o,
  input logic [31:0] compute_result_data_i,
  output logic [31:0] observe_o,
  output logic [3:0] quant_cancelled_o,
  output logic [3:0] quant_written_o,
  quant_write_fault_o,
  input logic quant_enable_i,
  quant_pack_i,
  input logic [31:0] quant_dst_i,
  output logic [3:0] be_o,
  input logic clk_i,
  rst_ni,
  start_i,
  input logic [31:0] a_i,
  b_i,
  d_i,
  input logic [15:0] lda_i,
  ldb_i,
  ldc_i,
  input logic [4:0] m_i,
  n_i,
  flags_i,
  input logic [8:0] k_i,
  input logic precision_i,
  input logic [1:0] element_log2_i,
  output logic busy_o,
  done_o,
  fault_o,
  req_o,
  we_o,
  output logic [31:0] addr_o,
  wdata_o,
  input logic gnt_i,
  rvalid_i,
  error_i,
  input logic [31:0] rdata_i
);
  import npu_addr_pkg::*;
  typedef enum logic [3:0] {
    IDLE,
    CLEAR,
    FETCH,
    WAIT_WORDS,
    C_REQ,
    C_WAIT,
    EMIT,
    D_REQ,
    D_WAIT,
    DRAIN,
    PACK_STEP
  } state_t;
  state_t state;
  // Parent MMIO validates complete input/raw-D spans in the 0x80000000
  // aperture before dispatch. Fifteen-bit byte offsets therefore preserve all
  // active addresses; FIFO cursors retain their independent low-byte wrap.
  logic [14:0] a_tile, b_tile, b_origin, d_base;
  logic [14:0] d_cursor, d_tile_cursor, d_row_cursor, d_row_step;
  logic [14:0] ldc_bytes;
  assign ldc_bytes = (ldc_i != 0 ? 15'(ldc_i) : 15'(n_i)) << 2;
  logic [14:0] a_row_step, a_k_step, b_col_step, b_k_step;
  logic [7:0][14:0] operand_ptr, initial_ptr;
  logic a_stream, b_stream, d_stream;
  logic [7:0] row_index, tile_index, linear_index;
  logic [7:0] row_index_step;
  logic [14:0] lda_bytes, ldb_bytes, element_bytes;
  logic [15:0] lda_value, ldb_value;
  logic [4:0] m, n, flags, tile_row, tile_col;
  logic [8:0] k, inner;
  logic [1:0] out_r, out_c;
  logic [2:0] rows, cols;
  logic precision;
  logic [7:0] word_valid, needed;
  logic [7:0][31:0] operand_addr, word_data;
  logic [7:0][12:0] word_tag;
  logic [2:0] batch_mask, batch_error;
  logic [2:0][31:0] batch_addresses, batch_data;
  logic [2:0][7:0] targets, reply_targets;
  logic batch_ready, batch_valid, batch_req, all_available, response_error;
  logic [31:0] batch_addr, d_address, output_address;
  logic pack_mode, pack_ready, pack_busy, pack_req, pack_pending;
  logic ordinary_req, ordinary_gnt, ordinary_valid;
  logic [31:0] pack_address, pack_data;
  logic [3:0] pack_be;
  logic [2:0] pack_count, pack_pending_count, quant_write_pending;
  assign ordinary_gnt = gnt_i && !pack_req;
  assign ordinary_valid = rvalid_i && !pack_pending;
  assign pack_mode = quant_enable_i && quant_pack_i && !is_stream_address(output_address);
  npu_store_pack i_write_pack (
    .clk_i,
    .rst_ni,
    .flush_i(response_error || start_i),
    .enable_i(quant_enable_i && quant_pack_i),
    .valid_i(state == D_REQ && compute_result_valid_i && pack_mode),
    .ready_o(pack_ready),
    .addr_i(output_address),
    .data_i(compute_result_data_i[7:0]),
    .last_i(tile_row + 5'(rows) == m && tile_col + 5'(cols) == n && {1'b0,out_r}+3'd1 == rows && {1'b0,out_c}+3'd1 == cols),
    .busy_o(pack_busy),
    .req_o(pack_req),
    .addr_o(pack_address),
    .data_o(pack_data),
    .be_o(pack_be),
    .count_o(pack_count),
    .cancelled_o(quant_cancelled_o),
    .gnt_i(gnt_i && pack_req)
  );
  function automatic logic [14:0] advance_input(input logic [14:0] ptr, step, input logic stream);
    return stream ? {ptr[14:8], 8'b0} : ptr + step;
  endfunction
  assign lda_value = lda_i != 0 ? lda_i : flags_i[0] ? 16'(m_i) : 16'(k_i);
  assign ldb_value = ldb_i != 0 ? ldb_i : flags_i[1] ? 16'(k_i) : 16'(n_i);
  assign element_bytes = 15'd1 << element_log2_i;
  assign lda_bytes = 15'(lda_value) << element_log2_i;
  assign ldb_bytes = 15'(ldb_value) << element_log2_i;
  assign row_index_step = 8'(n) << 2;
  assign initial_ptr[0] = a_tile;
  assign initial_ptr[4] = b_tile;
  for (genvar lane = 1; lane < 4; lane++) begin : g_initial_ptr
    assign initial_ptr[lane] = advance_input(initial_ptr[lane-1], a_row_step, a_stream);
    assign initial_ptr[lane+4] = advance_input(initial_ptr[lane+3], b_col_step, b_stream);
  end
  // FIFO tokens are tile-major, K-major, A rows then B columns; one word/lane.
  // Streaming operands cannot be reread: producers repeat them for each tile.
  assign rows = m - tile_row >= 5'd4 ? 3'd4 : 3'(m - tile_row);
  assign cols = n - tile_col >= 5'd4 ? 3'd4 : 3'(n - tile_col);
  assign d_address = {17'h10000, advance_input(d_base, d_cursor, d_stream)};
  // Quant destinations retain full address carry/fault semantics. Only the
  // already-validated operand and raw-D apertures use bounded offsets.
  assign output_address = quant_enable_i ? data_advance(
      quant_dst_i, {24'b0, linear_index} << (quant_pack_i ? 0 : 2)
  ) : d_address;
  assign all_available = needed == 0;
  function automatic logic signed [15:0] unpack_value(input logic [31:0] word,
                                                      input logic [1:0] offset, input logic wide);
    logic [31:0] shifted;
    shifted = word >> {offset, 3'b0};
    return wide ? $signed(shifted[15:0]) : $signed({{8{shifted[7]}}, shifted[7:0]});
  endfunction
  always_comb begin
    logic [7:0] covered;
    logic found;
    needed = 0;
    operand_addr = 0;
    compute_a_o = 0;
    compute_b_o = 0;
    compute_row_mask_o = 0;
    compute_col_mask_o = 0;
    for (int lane = 0; lane < 4; lane++) begin
      operand_addr[lane] = {17'h10000, operand_ptr[lane]};
      operand_addr[4+lane] = {17'h10000, operand_ptr[4+lane]};
      compute_row_mask_o[lane] = lane < int'(rows);
      compute_col_mask_o[lane] = lane < int'(cols);
      needed[lane]=lane<int'(rows) && !(word_valid[lane] && word_tag[lane]==operand_addr[lane][14:2]);
      needed[4+lane]=lane<int'(cols) && !(word_valid[4+lane] && word_tag[4+lane]==operand_addr[4+lane][14:2]);
      compute_a_o[lane] = unpack_value(word_data[lane], operand_addr[lane][1:0], precision);
      compute_b_o[lane] = unpack_value(word_data[4+lane], operand_addr[4+lane][1:0], precision);
    end
    covered = ~needed;
    batch_mask = 0;
    batch_addresses = 0;
    targets = 0;
    for (int p = 0; p < 3; p++) begin
      found = 0;
      for (int lane = 0; lane < 8; lane++)
      if (!covered[lane] && !found) begin
        found = 1;
        batch_mask[p] = 1;
        batch_addresses[p] = {operand_addr[lane][31:2], 2'b0};
        for (int other = 0; other < 8; other++)
        if (needed[other] && (other == lane || (!(lane<4 ? a_stream:b_stream) && operand_addr[other][31:2] == operand_addr[lane][31:2]))) begin
          targets[p][other] = 1;
          covered[other] = 1;
        end
      end
    end
  end
  npu_multi_read #(
    .GATHER(GATHER)
  ) i_operand_read (
    .clk_i,
    .rst_ni,
    .valid_i (state == FETCH && !all_available),
    .ready_o (batch_ready),
    .mask_i  (batch_mask),
    .addr_i  (batch_addresses),
    .valid_o (batch_valid),
    .ready_i (state == WAIT_WORDS),
    .data_o  (batch_data),
    .error_o (batch_error),
    .gather_req_o,
    .gather_addr_o,
    .gather_gnt_i,
    .gather_valid_i,
    .gather_error_i,
    .gather_data_i,
    .req_o   (batch_req),
    .addr_o  (batch_addr),
    .gnt_i   (ordinary_gnt && state == WAIT_WORDS),
    .rvalid_i(ordinary_valid && state == WAIT_WORDS),
    .error_i,
    .rdata_i
  );
  assign response_error=(state==WAIT_WORDS && batch_valid && |batch_error) ||
    (ordinary_valid && error_i && (state==C_WAIT || state==D_WAIT)) || (pack_pending && rvalid_i && error_i);
  assign compute_valid_o=(state==FETCH && all_available) || state==EMIT || (state==C_WAIT && ordinary_valid && !error_i);
  assign compute_multiply_o = state == FETCH;
  assign compute_emit_o = state == EMIT || state == C_WAIT;
  assign compute_index_o = {out_r, out_c};
  assign compute_addend_o = state == C_WAIT ? rdata_i : 0;
  assign compute_flush_o = state == CLEAR || response_error;
  assign quant_written_o = rvalid_i && !error_i ? (pack_pending ? 4'(pack_pending_count) : state == D_WAIT ? 4'(quant_write_pending) : 4'b0) : 4'b0;
  assign quant_write_fault_o = rvalid_i && error_i ? (pack_pending ? 4'(pack_pending_count) : state == D_WAIT ? 4'(quant_write_pending) : 4'b0) : 4'b0;
  assign observe_o = {
    busy_o, req_o, d_stream, b_stream, a_stream, out_c, out_r, tile_col, tile_row, inner, state
  };
  assign compute_result_ready_o = state == D_REQ && (pack_mode ? pack_ready : !pack_busy && ordinary_gnt);
  assign busy_o = state != IDLE;
  assign ordinary_req = (state == WAIT_WORDS && batch_req) || state == C_REQ || (state == D_REQ && compute_result_valid_i && !pack_mode && !pack_busy);
  assign req_o = pack_req || ordinary_req;
  assign we_o = pack_req || state == D_REQ;
  assign addr_o = pack_req ? pack_address : state == WAIT_WORDS ? batch_addr : state == D_REQ ? output_address : d_address;
  assign wdata_o = pack_req ? pack_data : compute_result_data_i;
  assign be_o = pack_req ? pack_be : 4'hf;
  always_ff @(posedge clk_i or negedge rst_ni) begin
    if (!rst_ni) begin
      pack_pending <= 0;
      pack_pending_count <= 0;
      quant_write_pending <= 0;
      state <= IDLE;
      done_o <= 0;
      fault_o <= 0;
      a_tile <= 0;
      b_tile <= 0;
      b_origin <= 0;
      d_base <= 0;
      a_row_step <= 0;
      a_k_step <= 0;
      b_col_step <= 0;
      b_k_step <= 0;
      a_stream <= 0;
      b_stream <= 0;
      d_stream <= 0;
      operand_ptr <= 0;
      d_cursor <= 0;
      d_tile_cursor <= 0;
      d_row_cursor <= 0;
      d_row_step <= 0;
      row_index <= 0;
      tile_index <= 0;
      linear_index <= 0;
      m <= 0;
      n <= 0;
      k <= 0;
      flags <= 0;
      precision <= 0;
      tile_row <= 0;
      tile_col <= 0;
      inner <= 0;
      out_r <= 0;
      out_c <= 0;
      word_valid <= 0;
      word_data <= 0;
      word_tag <= 0;
      reply_targets <= 0;
    end else begin
      pack_pending <= pack_req && gnt_i;
      if (pack_req && gnt_i) pack_pending_count <= pack_count;
      done_o <= 0;
      fault_o <= 0;
      if (response_error) begin
        state <= IDLE;
        fault_o <= 1;
      end else
        case (state)
          IDLE:
          if (start_i) begin
            a_tile <= a_i[14:0];
            b_tile <= b_i[14:0];
            b_origin <= b_i[14:0];
            d_base <= d_i[14:0];
            d_cursor <= 0;
            d_tile_cursor <= 0;
            d_row_cursor <= 0;
            d_row_step <= ldc_bytes;
            a_stream <= is_stream_address(a_i);
            b_stream <= is_stream_address(b_i);
            d_stream <= is_stream_address(d_i);
            a_row_step <= flags_i[0] ? element_bytes : lda_bytes;
            a_k_step <= flags_i[0] ? lda_bytes : element_bytes;
            b_col_step <= flags_i[1] ? ldb_bytes : element_bytes;
            b_k_step <= flags_i[1] ? element_bytes : ldb_bytes;
            row_index <= 0;
            tile_index <= 0;
            m <= m_i;
            n <= n_i;
            k <= k_i;
            flags <= flags_i;
            precision <= precision_i;
            tile_row <= 0;
            tile_col <= 0;
            state <= CLEAR;
          end
          CLEAR: begin
            word_valid <= 0;
            operand_ptr <= initial_ptr;
            linear_index <= tile_index;
            d_cursor <= d_tile_cursor;
            inner <= 0;
            out_r <= 0;
            out_c <= 0;
            state <= k == 0 ? C_REQ : FETCH;
          end
          FETCH:
          if (all_available) begin
            if (compute_ready_i) begin
              if (inner + 1 == k) state <= flags[2] ? C_REQ : EMIT;
              else begin
                inner <= inner + 1;
                // A FIFO read is destructive. Retain SRAM/RF word reuse only.
                if (a_stream) word_valid[3:0] <= 0;
                if (b_stream) word_valid[7:4] <= 0;
                for (int lane = 0; lane < 4; lane++) begin
                  operand_ptr[lane] <= advance_input(operand_ptr[lane], a_k_step, a_stream);
                  operand_ptr[4+lane] <= advance_input(operand_ptr[4+lane], b_k_step, b_stream);
                end
              end
            end
          end else if (batch_ready) begin
            reply_targets <= targets;
            state <= WAIT_WORDS;
          end
          WAIT_WORDS:
          if (batch_valid) begin
            for (int p = 0; p < 3; p++)
            for (int lane = 0; lane < 8; lane++)
            if (reply_targets[p][lane]) begin
              word_data[lane] <= batch_data[p];
              word_tag[lane] <= operand_addr[lane][14:2];
              word_valid[lane] <= 1;
            end
            state <= FETCH;
          end
          C_REQ: if (ordinary_gnt) state <= C_WAIT;
          C_WAIT: if (ordinary_valid && compute_ready_i) state <= D_REQ;
          EMIT: if (compute_ready_i) state <= D_REQ;
          D_REQ: begin
            if (pack_mode) begin
              if (compute_result_valid_i && pack_ready) state <= PACK_STEP;
            end else if (ordinary_gnt) begin
              quant_write_pending <= 3'(quant_enable_i);
              state <= D_WAIT;
            end
          end
          D_WAIT, PACK_STEP:
          if (state == PACK_STEP || ordinary_valid) begin
            if ({1'b0, out_c} + 3'd1 < cols) begin
              out_c <= out_c + 1;
              linear_index <= linear_index + 1;
              d_cursor <= d_cursor + 4;
              state <= flags[2] ? C_REQ : EMIT;
            end else if ({1'b0, out_r} + 3'd1 < rows) begin
              out_r <= out_r + 1;
              linear_index <= linear_index + 8'(n) - 8'(cols) + 1;
              d_cursor <= d_cursor + d_row_step - (15'(cols) << 2) + 4;
              out_c <= 0;
              state <= flags[2] ? C_REQ : EMIT;
            end else if (tile_col + 5'(cols) < n) begin
              tile_col <= tile_col + 5'(cols);
              b_tile <= advance_input(b_tile, b_col_step << 2, b_stream);
              tile_index <= tile_index + 8'(cols);
              d_tile_cursor <= d_tile_cursor + (15'(cols) << 2);
              state <= CLEAR;
            end else if (tile_row + 5'(rows) < m) begin
              tile_row <= tile_row + 5'(rows);
              a_tile <= advance_input(a_tile, a_row_step << 2, a_stream);
              b_tile <= b_origin;
              d_row_cursor <= d_row_cursor + (d_row_step << 2);
              d_tile_cursor <= d_row_cursor + (d_row_step << 2);
              row_index <= row_index + row_index_step;
              tile_index <= row_index + row_index_step;
              tile_col <= 0;
              state <= CLEAR;
            end else begin
              if (pack_busy || pack_pending) state <= DRAIN;
              else begin
                state <= IDLE;
                done_o <= 1;
              end
            end
          end
          DRAIN:
          if (!pack_busy && !pack_pending) begin
            state <= IDLE;
            done_o <= 1;
          end
          default: state <= IDLE;
        endcase
    end
  end
endmodule
