CatalpaEel/mynpu/npu/tb/tb_software_config.sv

`timescale 1ns / 1ps
// Real MMIO descriptors and real compute units; no peeking into compute values.
module tb_software_config;
  logic clk = 0, rst_n = 0;
  always #10 clk = ~clk;
  logic tck = 0, tms = 1, tdi = 0;
  wire tdo;
  `include "db_jtag_tasks.svh"
  `include "db_sba_access.svh"
  npu_soc dut (
    .clk_i             (clk),
    .rst_ni            (rst_n),
    .cpu_run_i         (1'b0),
    .tck_i             (tck),
    .tms_i             (tms),
    .td_i              (tdi),
    .td_o              (tdo),
    .cpu_debug_halted_o(),
    .irq_o             (),
    .cpu_test_done_o   (),
    .cpu_test_pass_o   ()
  );
  int checks = 0;
  localparam logic [31:0] INPUT_A=32'h80001400, OUTPUT_D=32'h80001700,
    WEIGHTS=32'h80002000, MATRIX_B=32'h80002020, CHANNEL=32'h80006000;
  task automatic bus(input bit we, input logic [31:0] a, d, output logic [31:0] result);
    sba_access(we, a, d, 4'hf, 0, result);
  endtask
  task automatic wr(input logic [31:0] a, d);
    logic [31:0] ignored;
    bus(1, a, d, ignored);
  endtask
  task automatic rd(input logic [31:0] a, output logic [31:0] d);
    bus(0, a, 0, d);
  endtask
  localparam logic [31:0] M='h40000000, S0='h80006000, S1='h80006100, S2='h80006200, S3='h80006300;
  task automatic restart;
    @(negedge clk);
    rst_n = 0;
    repeat (5) @(negedge clk);
    rst_n = 1;
    repeat (8) @(negedge clk);
  endtask
  task automatic expect_word(input logic [31:0] a, v);
    logic [31:0] got;
    rd(a, got);
    if (got !== v) $fatal(1, "software-config addr=%h got=%h expected=%h", a, got, v);
    checks++;
  endtask
  task automatic foreach_readonly;
    logic [31:0] ignored;
    int offsets[33] = '{
        'h084,
        'h144,
        'h148,
        'h14c,
        'h150,
        'h154,
        'h238,
        'h23c,
        'h280,
        'h284,
        'h288,
        'h634,
        'h638,
        'h63c,
        'h648,
        'h64c,
        'h650,
        'h724,
        'h728,
        'h72c,
        'h730,
        'h734,
        'h738,
        'h764,
        'h768,
        'h76c,
        'h770,
        'h774,
        'h778,
        'h128,
        'h228,
        'h73c,
        'h77c
    };
    foreach (offsets[i]) begin
      logic [31:0] ignored;
      sba_access(1, M + 32'(offsets[i]), 'hffffffff, 15, 1, ignored);
      checks++;
    end
    expect_word(M + 'h144, 0);
    expect_word(M + 'h634, 0);
    expect_word(M + 'h764, 0);
    expect_word(M + 'h76c, 0);
  endtask
  task automatic queue_started(input int page);
    logic [31:0] q;
    for (int i = 0; i < 1000; i++) begin
      rd(M + 32'(page) + (page == 'h600 ? 'h58 : 'h24), q);
      if (q[15:0] == 0) return;
    end
    $fatal(1, "task did not dispatch");
  endtask
  task automatic finish_unit(input int page, input int count);
    logic [31:0] status, completed;
    for (int i = 0; i < 5000; i++) begin
      rd(M + 32'(page) + 4, status);
      if (status[2]) $fatal(1, "unit fault page=%h status=%h", page, status);
      rd(M + 32'(page) + (page == 'h600 ? 'h5c : 'h28), completed);
      if (!status[0] && completed == 32'(count)) return;
    end
    $fatal(1, "unit failed to complete page=%h count=%0d", page, count);
  endtask
  task automatic fault_unit(input int page);
    logic [31:0] status;
    for (int i = 0; i < 2000; i++) begin
      rd(M + 32'(page) + 4, status);
      if (status[2] && !status[0]) return;
    end
    $fatal(1, "unit did not report failed write page=%h", page);
  endtask
  task automatic kernel(input logic [31:0] address, input int weight);
    wr(address, 0);
    wr(address + 4, 32'(weight));
    wr(address + 8, 0);
  endtask
  task automatic matrix_one(input logic [31:0] source);
    wr('h80002000, 2);
    wr(M + 'h108, source);
    wr(M + 'h10c, 'h80002000);
    wr(M + 'h110, 'h80001900);
    wr(M + 'h114, 1);
    wr(M + 'h118, 1);
    wr(M + 'h11c, 1);
    wr(M + 'h130, 0);
    wr(M + 'h134, 0);
    wr(M + 'h138, 0);
    wr(M + 'h13c, 0);
    wr(M + 'h140, 4);
    wr(M + 'h100, 1);
  endtask
  task automatic quant_setup(input int mode, mul, bias, zero, input logic [31:0] dst);
    wr(M + 'h740, 0);
    wr(M + 'h744, 32'(mul));
    wr(M + 'h748, 32'(bias));
    wr(M + 'h74c, 0);
    wr(M + 'h750, 32'(zero));
    wr(M + 'h754, 0);
    wr(M + 'h758, 'h7fffffff);
    wr(M + 'h75c, 0);
    wr(M + 'h760, dst);
    wr(M + 'h740, 32'(mode));
  endtask
  initial begin
    logic [31:0] status;
    restart();
    expect_word(M + 'h080, 'hf);
    expect_word(M + 'h084, 'h0002007f);
    foreach_readonly();
    // Active CNN geometry is latched; queued geometry is intentionally late-bound.
    kernel('h80002000, 2);
    kernel('h80002020, 3);
    wr('h80001400, 9);
    wr('h80001800, 'hdeadbeef);
    wr('h80001810, 'hdeadbeef);
    wr(M + 'h608, S0);
    wr(M + 'h60c, 'h80002000);
    wr(M + 'h610, 'h80001800);
    wr(M + 'h614, 1);
    wr(M + 'h618, 'h800040f0);
    wr(M + 'h61c, 1);
    wr(M + 'h620, 1);
    wr(M + 'h624, 1);
    wr(M + 'h62c, 0);
    wr(M + 'h628, npu_stream_pkg::encode_task(0, 0, 1, 2, 1, 1, 0));
    wr(M + 'h600, 1);
    queue_started('h600);
    wr(M + 'h600, 1);
    rd(M + 'h604, status);
    if (!status[0]) $fatal(1, "CNN not active for runtime writes");
    wr(M + 'h608, 'h80001400);
    wr(M + 'h60c, 'h80002020);
    wr(M + 'h610, 'h80001810);
    expect_word(M + 'h658, (`NPU_CNN_QUEUE_DEPTH << 16) | 1);
    expect_word(M + 'h634, 1);
    expect_word(M + 'h638, 1);
    expect_word(M + 'h65c, 0);
    rd(M + 'h64c, status);
    if (!status[31]) $fatal(1, "CNN observation lost active state");
    wr(S0, 6);
    finish_unit('h600, 2);
    expect_word('h80001800, 12);
    expect_word('h80001810, 27);
    expect_word(M + 'h634, 2);
    expect_word(M + 'h638, 2);
    expect_word(M + 'h63c, 0);
    expect_word(M + 'h648, 0);
    $display("SOFTWARE CONFIG CNN PASS active-old/queued-new/nonempty-FIFO/runtime-writes");

    restart();
    // Program count is latched per job; instruction words are read live.
    wr(M + 'h208, S1);
    wr(M + 'h218, 0);
    wr(M + 'h20c, 'h80001800);
    wr(M + 'h210, 1);
    wr(M + 'h214, 'h20);
    wr(M + 'h234, 1);
    wr(M + 'h240, 2);
    wr(M + 'h200, 1);
    queue_started('h200);
    wr(M + 'h20c, 'h80001810);
    wr(M + 'h200, 1);
    wr(M + 'h234, 2);
    wr(M + 'h240, (7 << 12) | (1 << 5) | 1);
    wr(M + 'h244, (2 << 12) | (1 << 5) | 24);
    expect_word(M + 'h224, (`NPU_VECTOR_QUEUE_DEPTH << 16) | 1);
    expect_word(M + 'h238, 1);
    expect_word(M + 'h23c, 1);
    rd(M + 'h284, status);
    if (!status[31] || status[13:9] != 1) $fatal(1, "Vector active slots observation");
    wr(S1, 5);
    wr(S1, 6);
    finish_unit('h200, 2);
    expect_word('h80001800, 12);
    expect_word('h80001810, 26);
    expect_word(M + 'h238, 2);
    expect_word(M + 'h23c, 2);
    expect_word(M + 'h280, 0);
    $display("SOFTWARE CONFIG VECTOR PASS active-program-live/count-latched/queued-count-new");

    restart();
    // A pending Matrix result sees parameters changed before quant accepts it.
    wr('h80001a00, 'hdeadbeef);
    wr('h80001a04, 'hdeadbeef);
    quant_setup(3, 3, 0, 0, 'h80001a00);
    matrix_one(S2);
    queue_started('h100);
    rd(M + 'h104, status);
    if (!status[0]) $fatal(1, "Matrix not active for quant writes");
    wr(M + 'h744, 4);
    wr(M + 'h748, 1);
    wr(M + 'h750, 2);
    wr(M + 'h760, 'h80001a04);
    expect_word(M + 'h144, 1);
    expect_word(M + 'h148, 1);
    expect_word(M + 'h764, 0);
    expect_word(M + 'h76c, 0);
    wr(S2, 6);
    finish_unit('h100, 1);
    expect_word('h80001a00, 'hdeadbeef);
    expect_word('h80001a04, 'hdeadbe33);
    expect_word(M + 'h764, 1);
    expect_word(M + 'h768, 1);
    expect_word(M + 'h76c, 1);
    expect_word(M + 'h770, 0);
    $display("SOFTWARE CONFIG QUANT PASS active-source/pre-accept-parameters/new-destination");

    restart();
    // Arithmetic already in flight stays latched; destination remains live.
    quant_setup(1, 3, 0, 0, S3);
    wr('h80001400, 6);
    for (int i = 0; i < npu_addr_pkg::STREAM_FIFO_DEPTH; i++) wr(S3, 'hface0000 + 32'(i));
    matrix_one('h80001400);
    for (int i = 0; i < 1000; i++) begin
      @(negedge clk);
      if (dut.i_core.quant_out_valid[1] && !dut.i_core.quant_out_ready[1]) break;
      if (i == 999) $fatal(1, "quant result did not reach backpressure");
    end
    expect_word(M + 'h764, 1);
    expect_word(M + 'h768, 0);
    expect_word(M + 'h76c, 0);
    repeat (20) @(negedge clk);
    expect_word(M + 'h764, 1);  // Stalled output never resamples arithmetic.
    rd(M + 'h778, status);
    if (!status[4] || status[5]) $fatal(1, "quant blocked status");
    wr(M + 'h744, 9);
    wr(M + 'h748, 7);
    wr(M + 'h750, 5);
    wr(M + 'h760, 'h80001a00);
    finish_unit('h100, 1);
    expect_word('h80001a00, 36);
    for (int i = 0; i < npu_addr_pkg::STREAM_FIFO_DEPTH; i++) expect_word(S3, 'hface0000 + 32'(i));
    matrix_one('h80001400);
    finish_unit('h100, 2);
    expect_word('h80001a00, 120);
    expect_word(M + 'h144, 2);
    expect_word(M + 'h148, 2);
    expect_word(M + 'h764, 2);
    expect_word(M + 'h768, 2);
    expect_word(M + 'h76c, 2);
    expect_word(M + 'h770, 0);
    expect_word(M + 'h774, 0);
    $display(
        "SOFTWARE CONFIG QUANT INFLIGHT PASS arithmetic-latched/destination-live/FIFO-unchanged/next-result-new");
    restart();
    // Quant destination is valid for one word; the second output faults.
    // A successful write ACK and an error ACK must remain distinguishable.
    quant_setup(1, 1, 0, 0, 'h800040fc);
    wr('h80001400, 6);
    wr('h80002000, 2);
    wr('h80002004, 3);
    wr(M + 'h108, 'h80001400);
    wr(M + 'h10c, 'h80002000);
    wr(M + 'h110, 'h80001900);
    wr(M + 'h114, 1);
    wr(M + 'h118, 2);
    wr(M + 'h11c, 1);
    wr(M + 'h100, 1);
    fault_unit('h100);
    expect_word('h800040fc, 12);
    expect_word(M + 'h144, 1);
    expect_word(M + 'h14c, 1);
    expect_word(M + 'h128, 0);
    expect_word(M + 'h764, 2);
    expect_word(M + 'h768, 2);
    expect_word(M + 'h76c, 1);
    expect_word(M + 'h770, 1);

    restart();
    kernel('h80002000, 2);
    wr('h80001400, 'h0706);
    wr(M + 'h704, 1);
    wr(M + 'h718, 'h7fffffff);
    wr(M + 'h720, 'h800040fc);
    wr(M + 'h700, 1);
    wr(M + 'h608, 'h80001400);
    wr(M + 'h60c, 'h80002000);
    wr(M + 'h610, 'h80001800);
    wr(M + 'h614, 2);
    wr(M + 'h618, 'h800040e0);
    wr(M + 'h61c, 1);
    wr(M + 'h620, 1);
    wr(M + 'h624, 2);
    wr(M + 'h628, npu_stream_pkg::encode_task(0, 0, 2, 2, 1, 1, 0));
    wr(M + 'h600, 1);
    fault_unit('h600);
    expect_word('h800040fc, 12);
    expect_word(M + 'h634, 1);
    expect_word(M + 'h63c, 1);
    expect_word(M + 'h65c, 0);
    expect_word(M + 'h724, 2);
    expect_word(M + 'h728, 2);
    expect_word(M + 'h72c, 1);
    expect_word(M + 'h730, 1);
    restart();
    // Coalesced errors count result elements, not just physical write beats.
    kernel('h80002000, 2);
    wr('h80001400, 'h09080706);
    wr('h80001404, 10);
    wr('h800040fc, 'hdeadbeef);
    wr(M + 'h704, 1);
    wr(M + 'h718, 'h7fffffff);
    wr(M + 'h720, 'h800040fd);
    wr(M + 'h700, 3);
    wr(M + 'h608, 'h80001400);
    wr(M + 'h60c, 'h80002000);
    wr(M + 'h610, 'h80001800);
    wr(M + 'h614, 5);
    wr(M + 'h618, 'h800040e0);
    wr(M + 'h61c, 1);
    wr(M + 'h620, 1);
    wr(M + 'h624, 5);
    wr(M + 'h628, npu_stream_pkg::encode_task(0, 0, 5, 2, 1, 1, 0));
    wr(M + 'h600, 1);
    fault_unit('h600);
    expect_word('h800040fc, 'h100e0cef);
    expect_word(M + 'h724, 5);
    expect_word(M + 'h728, 5);
    expect_word(M + 'h72c, 3);
    expect_word(M + 'h730, 2);
    expect_word(M + 'h73c, 0);
    expect_word(M + 'h63c, 1);

    restart();
    quant_setup(3, 1, 0, 0, 'h800040fd);
    wr('h800040fc, 'hdeadbeef);
    wr('h80001400, 6);
    for (int n = 0; n < 5; n++) wr('h80002000 + 32'(4 * n), 32'(n + 2));
    wr(M + 'h108, 'h80001400);
    wr(M + 'h10c, 'h80002000);
    wr(M + 'h110, 'h80001900);
    wr(M + 'h114, 1);
    wr(M + 'h118, 5);
    wr(M + 'h11c, 1);
    wr(M + 'h100, 1);
    fault_unit('h100);
    expect_word('h800040fc, 'h18120cef);
    expect_word(M + 'h764, 5);
    expect_word(M + 'h768, 5);
    expect_word(M + 'h76c, 3);
    expect_word(M + 'h770, 2);
    expect_word(M + 'h77c, 0);
    expect_word(M + 'h14c, 1);
    $display(
        "SOFTWARE CONFIG SYNC PASS readonly/start-tickets/observe/quant-stalls/real-write-ACK/errors");
    $display(
        "SOFTWARE CONFIG PASS checks=%0d CNN/Matrix/Vector/quant runtime ownership and sampling boundaries",
        checks);
    $finish;
  end
  initial begin
    #100000000000;
    $fatal(1, "software config timeout");
  end
endmodule
