CatalpaEel/mynpu/npu/rtl/vector/npu_vector.sv

// One configurable INT32 / four-lane INT8 ALU. Byte carry boundaries are
// disabled in SIMD mode. Add/sub/neg/abs, comparisons, shifts and partial
// multipliers are shared; there is no separate light ALU.
module npu_vector #(
  parameter bit PIPELINED_MUL = 0
) (
  input logic mul_simd_i,
  input logic [31:0] mul_a_i,
  mul_b_i,
  input logic [4:0] op_i,
  input logic simd_i,
  input logic [31:0] a_i,
  b_i,
  c_i,
  input logic carry_i,
  output logic carry_o,
  output logic [31:0] data_o
);
  logic [31:0] multiply_a, multiply_b;
  logic multiply_simd;
  assign multiply_simd = PIPELINED_MUL ? mul_simd_i : simd_i;
  assign multiply_a = PIPELINED_MUL ? mul_a_i : a_i;
  assign multiply_b = PIPELINED_MUL ? mul_b_i : b_i;
  logic [31:0] p00, p01, p10, p11, middle, product_low, product_high;
  logic [31:0] lhs, rhs, sum, high_base, correction_a, correction_b, signed_high;
  logic subtract;
  logic [4:0] carries;
  logic [3:0] byte_equal, byte_less, byte_signed_less;
  logic unsigned_less, signed_less;
  logic [31:0] shift_stage[6];
  logic [31:0] pair_shifted, pair_mask;
  logic [5:0] pair_amount;
  // Reuse the existing four 16x16 partial multipliers as four 8x8 lanes.
  assign p00 = (multiply_simd ? {8'b0, multiply_a[7:0]} : multiply_a[15:0]) * (multiply_simd ? {8'b0, multiply_b[7:0]} : multiply_b[15:0]);
  assign p01 = (multiply_simd ? {8'b0, multiply_a[15:8]} : multiply_a[15:0]) * (multiply_simd ? {8'b0, multiply_b[15:8]} : multiply_b[31:16]);
  assign p10=(multiply_simd ? {8'b0,multiply_a[23:16]}:multiply_a[31:16]) * (multiply_simd ? {8'b0,multiply_b[23:16]}:multiply_b[15:0]);
  assign p11=(multiply_simd ? {8'b0,multiply_a[31:24]}:multiply_a[31:16]) * (multiply_simd ? {8'b0,multiply_b[31:24]}:multiply_b[31:16]);
  assign middle = {16'b0, p00[31:16]} + {16'b0, p01[15:0]} + {16'b0, p10[15:0]};
  assign product_low=multiply_simd ? {p11[7:0],p10[7:0],p01[7:0],p00[7:0]} : {middle[15:0],p00[15:0]};
  assign product_high=multiply_simd ? {p11[15:8],p10[15:8],p01[15:8],p00[15:8]} : p11+{16'b0,p01[31:16]}+{16'b0,p10[31:16]}+{16'b0,middle[31:16]};
  function automatic logic [31:0] segmented_sub(input logic [31:0] x, y, input logic segmented);
    logic carry;
    logic [8:0] value;
    logic [31:0] result;
    carry = 1;
    result = 0;
    for (int lane = 0; lane < 4; lane++) begin
      value = {1'b0, x[8*lane+:8]} + {1'b0, ~y[8*lane+:8]} + 9'(carry);
      result[8*lane+:8] = value[7:0];
      carry = segmented ? 1'b1 : value[8];
    end
    return result;
  endfunction
  always_comb begin
    correction_a = 0;
    correction_b = 0;
    for (int lane = 0; lane < 4; lane++) begin
      correction_a[8*lane+:8]=multiply_simd ? (multiply_a[8*lane+7] ? multiply_b[8*lane+:8]:8'b0) : (multiply_a[31] ? multiply_b[8*lane+:8]:8'b0);
      correction_b[8*lane+:8]=multiply_simd ? (multiply_b[8*lane+7] ? multiply_a[8*lane+:8]:8'b0) : (multiply_b[31] ? multiply_a[8*lane+:8]:8'b0);
    end
  end
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
