CatalpaEel/mynpu/(commit log)

2026-11-07 Checkpoint shared INT32 SIMD8 vector ALU and current NPU optimizations
2026-11-10 Add general workload scheduling and validate 1950um full-chip flow
2026-11-11 Refresh project documentation and prepare EGo1 board build flow
2026-11-11 Keep current design reports and remove superseded measurement data
2026-11-14 Add board-ready 10MHz FPGA validation variant
2026-11-14 Finalize FPGA board kit status
2026-11-14 Unify SoC access through JTAG SBA and add GPIO8
    Remove the external Host interface and migrate SoC regressions to pin-level JTAG. Add SBA error and subword support, running CPU/NPU concurrency coverage, and GPIO8 with native PAD integration.
    Record 19 passing functional runs, preserve prior physical results as frozen baselines, and document backend commands, area optimization and DRC repairs. Physical-board SBA verification and new PPA remain pending.
2026-11-14 Archive EGo1 10 MHz board validation for afb74fd
    Freeze the actual hardware inputs matching 03e2870, FPGA bit/MCS,
    validation firmware/model assets, routed reports and raw board evidence.
    Record 2021 checked frames at 10 MHz system / 100 kHz external JTAG.
    Use halt/access/resume for PC memory access and retain failing attempts;
    direct running SBA access remains unresolved. Keep shared ASIC RTL at
    afb74fd and explicitly exclude later main changes from these results.
    Publish fpga/ego1-board-20261114-afb74fd and the immutable reference
    ego1-board-10mhz-20261114 with byte-level manifests and reuse instructions.
2026-11-14 Remove GPIO from main and retain JTAG-only access
    Withdraw GPIO RTL, MMIO/API, external pins, additional PADs, tests and GPIO-specific reports. Preserve JTAG SBA changes, paired PAD work and backend tutorials.
    Revalidate the no-GPIO design: JTAG macro regression, CPU/NPU running SBA stress, ten MNIST samples and EGo1 wrapper simulation. Replace the GPIO-snapshot validation with these four corrected runs.
